rodgutzal/Airsoft-MultipurposeGameModeTool/Hw/esquematico_v1/lista_materiales_v0.9_opcionC.xlsx

Sheet: Opción C (discreta PCB)
Herramienta multipropósito para airsoft: lista de materiales opción C
Todo discreto para PCB propia: ESP32-S3-WROOM-1 N16R8, TP4056 + DW01A/FS8205A, TPS61022, AP7361C, MAX98357A suelto, USB-C. Esquemático v0.9 opción C. Precios en MXN, aproximados. 8 de noviembre de 2026.
Celdas con texto azul: cantidades y precios que se pueden editar. Los subtotales y totales se recalculan solos.
Cant. | Referencias | Pieza | Bloque | Precio unitario (MXN) | Subtotal (MXN) | Estado del precio
1 | U1 | Módulo ESP32-S3-WROOM-1-N16R8 (flash 16 MB quad, PSRAM 8 MB octal), sin tarjeta de desarrollo | Microcontrolador | $120.00 |  | Estimado, sin verificar
1 | U9 | Regulador LDO AP7361C-33E, 3.3 V 1 A, SOT-223 | Alimentación | $8.00 |  | Estimado, sin verificar
1 | SW5 | Botón táctil 6x6 mm (RESET, a EN) | Microcontrolador | $2.00 |  | Estimado, sin verificar
1 | SW6 | Botón táctil 6x6 mm (BOOT, a GPIO0) | Microcontrolador | $2.00 |  | Estimado, sin verificar
1 | J1 | Conector USB-C hembra 16 pines USB 2.0, SMD con postes | USB y depuración | $6.00 |  | Estimado, sin verificar
1 | U7 | Protección ESD USBLC6-2SC6, SOT-23-6 (D+ y D-) | USB y depuración | $5.00 |  | Estimado, sin verificar
1 | J2 | Header macho 1x6 a 2.54 mm (GND, TX0, RX0, EN, IO0, 3V3) | USB y depuración | $3.00 |  | Estimado, sin verificar
1 | DS1 | Módulo TFT 3.5in 480x320 ILI9486 ("3.5' LCD MODULE"), bus paralelo 8080 de 16 bits, touch resistivo XPT2046 por SPI, microSD y conector 2x17 | Pantalla | $300.00 |  | Roy ya lo tiene; precio estimado
1 |  | Header hembra 2x17 a 2.54 mm para conectar DS1 a la PCB | Pantalla | $15.00 |  | Estimado, sin verificar
1 | KP1 | Teclado de membrana 4x4 | Entradas | $40.00 |  | Estimado, sin verificar
1 | U6 | Expansor de E/S I2C MCP23017-E/SP DIP-28 (teclado, switches, botón, PEN, BL, SD del amplificador, USB presente) | Entradas | $50.00 |  | Estimado, sin verificar
1 |  | Zócalo DIP-28 angosto para U6 | Entradas | $8.00 |  | Estimado, sin verificar
1 | SW1 | Interruptor de palanca (selector de equipo) | Entradas | $25.00 |  | Estimado, sin verificar
1 | SW2 | Interruptor de llave (armado de bomba) | Entradas | $80.00 |  | Estimado, sin verificar
1 | SW3 | Push button de panel 16 a 22 mm | Entradas | $40.00 |  | Estimado, sin verificar
2 | BT1, BT2 | Celda 18650 3000 mAh de marca (Samsung 30Q, LG HG2 o similar) | Alimentación | $120.00 |  | Estimado, sin verificar
1 |  | Portapilas 2x18650 para PCB (pines THT), celdas en paralelo | Alimentación | $35.00 |  | Estimado, sin verificar
1 | U10 | Protección de una celda DW01A, SOT-23-6 | Alimentación | $3.00 |  | Estimado, sin verificar
2 | Q1, Q2 | Doble MOSFET N FS8205A, TSSOP-8 (dos en paralelo) | Alimentación | $3.00 |  | Estimado, sin verificar
1 | U2 | Cargador Li-ion TP4056, ESOP-8 con pad expuesto, 1 A | Alimentación | $3.00 |  | Estimado, sin verificar
1 | D6 | LED rojo 0805 o 3 mm (cargando) | Alimentación | $1.00 |  | Estimado, sin verificar
1 | D7 | LED verde 0805 o 3 mm (carga terminada) | Alimentación | $1.00 |  | Estimado, sin verificar
1 | Q3 | MOSFET P AO3401A, SOT-23 (reparto de carga) | Alimentación | $2.00 |  | Estimado, sin verificar
2 | D8, D9 | Diodo Schottky SS34, SMA (D8 de VBUS a VSYS, D9 en paralelo con Q3) | Alimentación | $2.00 |  | Estimado, sin verificar
1 | SW4 | Interruptor de encendido de panel, 3 A o más (palanca o balancín) | Alimentación | $25.00 |  | Estimado, sin verificar
1 | U8 | Elevador síncrono TPS61022RWUR, VQFN-7 2x2 mm (5.1 V, válvula de 8 A) | Alimentación | $25.00 |  | Estimado, sin verificar
1 | L1 | Inductor de potencia blindado 1 uH, saturación de 8 A o más, baja DCR | Alimentación | $20.00 |  | Estimado, sin verificar
1 | DS2, DS3 | Tira LED RGB direccionable WS2812B 5 V, 60 LEDs/m, IP65, rollo de 1 m (2 tramos de 15 LEDs encadenados en un solo dato) | Salidas | $180.00 |  | Estimado, sin verificar
1 | U5 | 74AHCT125 DIP-14 (SN74AHCT125N), subida de nivel 3.3 a 5 V del dato de las tiras; el 74HCT125 también sirve | Salidas | $30.00 |  | Estimado, sin verificar
1 | D5 | LED verde 5 mm difuso, Vf ~2.1 V, LED de estado en GPIO43 | Salidas | $2.00 |  | Estimado, sin verificar
2 |  | Par de conectores JST SM de 3 pines con cable, para desconectar las tiras | Salidas | $10.00 |  | Estimado, sin verificar
1 | U4 | Amplificador I2S clase D MAX98357AETE+, TQFN-16 3x3 mm (circuito integrado suelto) | Audio | $45.00 |  | Estimado, sin verificar
1 | J4 | Conector de 2 pines para la bocina (JST XH o bornera de 3.5 mm) | Audio | $4.00 |  | Estimado, sin verificar
1 | LS1 | Bocina 4 ohm, 3 a 5 W, cono de 40 a 57 mm | Audio | $60.00 |  | Estimado, sin verificar
14 | R1, R2, R3, R4, R7, R17, R18, R19, R20, R22, R23, R24, R36, R37 | Resistencia 10k 0603 (pull-ups, EN, GPIO0, pull-down de GPIO45, RX0, gate de Q3) | Pasivos | $0.50 |  | Estimado, sin verificar
3 | R5, R8, R21 | Resistencia 330 ohm 0603 | Pasivos | $0.50 |  | Estimado, sin verificar
5 | R6, R9, R13, R14, R39 | Resistencia 100k 0603 | Pasivos | $0.50 |  | Estimado, sin verificar
1 | R16 | Resistencia 100k 1% 0603 (realimentación de U8) | Pasivos | $0.50 |  | Estimado, sin verificar
1 | R15 | Resistencia 750k 1% 0603 (realimentación de U8) | Pasivos | $0.50 |  | Estimado, sin verificar
1 | R30 | Resistencia 634k 1% 0603 (SD_MODE del MAX98357A) | Pasivos | $0.50 |  | Estimado, sin verificar
2 | R10, R11 | Resistencia 4.7k 0603 (pull-ups del I2C) | Pasivos | $0.50 |  | Estimado, sin verificar
2 | R25, R26 | Resistencia 5.1k 0603 (CC1 y CC2 del USB-C) | Pasivos | $0.50 |  | Estimado, sin verificar
2 | R27, R28 | Resistencia 22 ohm 0603 (D+ y D-) | Pasivos | $0.50 |  | Estimado, sin verificar
1 | R29 | Resistencia 499 ohm 0603 (TX0) | Pasivos | $0.50 |  | Estimado, sin verificar
1 | R31 | Resistencia 100 ohm 0603 (VCC del DW01A) | Pasivos | $0.50 |  | Estimado, sin verificar
3 | R32, R34, R35 | Resistencia 1k 0603 (CS del DW01A, LEDs de carga) | Pasivos | $0.50 |  | Estimado, sin verificar
1 | R33 | Resistencia 1.2k 1% 0603 (PROG del TP4056, 1 A) | Pasivos | $0.50 |  | Estimado, sin verificar
1 | R38 | Resistencia 47k 0603 (USB presente) | Pasivos | $0.50 |  | Estimado, sin verificar
7 | C1, C2, C4, C7, C9, C12, C14 | Capacitor cerámico 100 nF 0603 | Pasivos | $0.50 |  | Estimado, sin verificar
1 | C10 | Capacitor cerámico 1 uF 0603 (EN) | Pasivos | $0.50 |  | Estimado, sin verificar
6 | C13, C15, C16, C21, C22, C23 | Capacitor cerámico 10 uF 10 V X5R 0805 | Pasivos | $1.00 |  | Estimado, sin verificar
5 | C11, C17, C18, C19, C20 | Capacitor cerámico 22 uF 10 V X5R 0805 o 1206 | Pasivos | $1.50 |  | Estimado, sin verificar
1 | C3 | Capacitor electrolítico 470 uF 10 V | Pasivos | $8.00 |  | Estimado, sin verificar
1 | C8 | Capacitor electrolítico 1000 uF 10 V (entrada de las tiras) | Pasivos | $12.00 |  | Estimado, sin verificar
1 |  | PCB de 2 capas, unos 100 x 100 mm (JLCPCB o PCBWay, lote de 5 con envío, precio por pieza) | PCB | $80.00 |  | Estimado, sin verificar
Total sin gabinete
Margen para repuestos y piezas dañadas |  |  |  |  | 10%
Total con margen

Sheet: Notas
Comparación y supuestos
Total opción C (sin margen)
Total opción A v0.8 (módulos, de lista_materiales_v0.8.xlsx) | $1791.00
Total opción B v0.8 (TP4056 + MT3608, de lista_materiales_v0.8.xlsx) | $1635.00
Diferencia A menos C
Todos los precios de la opción C son estimaciones mías y no se verificaron en tienda. Los de piezas SMD salen de precios típicos de LCSC y AliExpress convertidos a unos 18.5 MXN por dólar; en esas tiendas se compra por lote (10 o más), así que el desembolso real es mayor que el precio por unidad.
El módulo ESP32-S3-WROOM-1-N16R8 se consigue en LCSC, AliExpress y Mercado Libre. Verificar que diga N16R8 (flash 16 MB, PSRAM 8 MB octal a 3.3 V) y no N16R16V, que trabaja la PSRAM y GPIO47/48 a 1.8 V.
TPS61022 (VQFN-7 de 2x2 mm) y MAX98357A (TQFN-16 de 3x3 mm) no se sueldan con cautín. Hace falta esténcil y aire caliente o placa de calor, o pedir el ensamble SMD a JLCPCB o PCBWay, que tienen las dos piezas en catálogo.
La PCB se estimó en 80 MXN por pieza para un lote de 5 de 2 capas con envío. Espressif recomienda 4 capas para el ESP32-S3; con el módulo WROOM funciona en 2 capas cuidando el plano de tierra y la zona de la antena.
No incluye gabinete, cables, tornillería ni el esténcil.
v0.9 opción C (8 de noviembre de 2026): se quitan el ESP32-S3-DevKitC-1, el módulo LUORNG V8 y la tarjeta MAX98357A. Entran U1 WROOM-1, U2 TP4056, U4 MAX98357A suelto, U7 USBLC6, U8 TPS61022, U9 AP7361C, U10 DW01A, Q1/Q2 FS8205A, Q3 AO3401A, D6 a D9, L1, J1 USB-C, J2 UART, J4 bocina, SW4 a SW6, R22 a R39 y C10 a C23.
Lo que no pude verificar con hoja de datos está en Hw/esquematico_v1/opcion_c/README.md, sección Sin verificar.
