rodgutzal/Airsoft-MultipurposeGameModeTool/Hw/esquematico_v1/lista_materiales_v0.8.xlsx

Sheet: Opción A (módulo)
Herramienta multipropósito para airsoft: lista de materiales opción A
Alimentación con módulo LUORNG V8 para 2 celdas 18650. Esquemático v0.8. Precios en MXN, aproximados. 8 de noviembre de 2026.
Celdas con texto azul: cantidades y precios que se pueden editar. Los subtotales y totales se recalculan solos.
Cant. | Referencias | Pieza | Bloque | Precio unitario (MXN) | Subtotal (MXN) | Estado del precio
1 | U1 | ESP32-S3-DevKitC-1 N16R8 | Microcontrolador | $300.00 |  | Estimado, sin verificar
1 | DS1 | Módulo TFT 3.5in 480x320 ILI9486 ("3.5' LCD MODULE"), bus paralelo 8080 de 16 bits, touch resistivo XPT2046 por SPI, microSD y conector 2x17 | Pantalla | $300.00 |  | Roy ya lo tiene; precio estimado
1 | KP1 | Teclado de membrana 4x4 | Entradas | $40.00 |  | Estimado, sin verificar
1 | U6 | Expansor de E/S I2C MCP23017-E/SP DIP-28 (teclado, switches, botón, PEN del touch y BL de la pantalla) | Entradas | $50.00 |  | Estimado, sin verificar
1 |  | Zócalo DIP-28 angosto para U6 | Entradas | $8.00 |  | Estimado, sin verificar
2 | BT1, BT2 | Celda 18650 3000 mAh de marca (Samsung 30Q, LG HG2 o similar) | Alimentación | $120.00 |  | Estimado, sin verificar
1 | M1 | Módulo LUORNG V8 para 2 celdas 18650, carga USB-C y micro USB, salida 5 V y 3 V | Alimentación | $278.10 |  | Precio en captura de Roy, 2 nov 2026
1 | SW1 | Interruptor de palanca (selector de equipo) | Entradas | $25.00 |  | Estimado, sin verificar
1 | SW2 | Interruptor de llave (armado de bomba) | Entradas | $80.00 |  | Estimado, sin verificar
1 | SW3 | Push button de panel 16 a 22 mm | Entradas | $40.00 |  | Estimado, sin verificar
1 | DS2, DS3 | Tira LED RGB direccionable WS2812B 5 V, 60 LEDs/m, IP65, rollo de 1 m (2 tramos de 15 LEDs encadenados en un solo dato) | Salidas | $180.00 |  | Estimado, sin verificar
1 | U5 | 74AHCT125 DIP-14 (SN74AHCT125N), subida de nivel 3.3 a 5 V del dato de las tiras (se usa un buffer); el 74HCT125 también sirve | Salidas | $30.00 |  | Estimado, sin verificar
1 | D5 | LED verde 5 mm difuso, Vf ~2.1 V (verde estándar de 565 a 570 nm), LED de estado en GPIO43 | Salidas | $2.00 |  | Estimado, sin verificar
2 |  | Par de conectores JST SM de 3 pines con cable, para desconectar las tiras | Salidas | $10.00 |  | Estimado, sin verificar
1 | U4 | Módulo amplificador I2S MAX98357A | Audio | $90.00 |  | Estimado, sin verificar
1 | LS1 | Bocina 4 ohm, 3 a 5 W, cono de 40 a 57 mm | Audio | $60.00 |  | Estimado, sin verificar
9 | R1, R2, R3, R4, R7, R17, R18, R19, R20 | Resistencia 10k (R2 a R4 y R17 a R20 son pull-ups de entradas, R7 al RESET de U6) | Pasivos | $1.00 |  | Estimado, sin verificar
3 | R5, R8, R21 | Resistencia 330 ohm (R5 en el dato de DS2, R8 entre DS2 y DS3, R21 limita el LED de estado) | Pasivos | $1.00 |  | Estimado, sin verificar
4 | R6, R9, R13, R14 | Resistencia 100k (R6 pull-down del dato de las tiras, R9 pull-down de arranque de GPIO46) | Pasivos | $1.00 |  | Estimado, sin verificar
2 | R10, R11 | Resistencia 4.7k (pull-ups del bus I2C) | Pasivos | $1.00 |  | Estimado, sin verificar
5 | C1, C2, C4, C7, C9 | Capacitor 100 nF | Pasivos | $2.00 |  | Estimado, sin verificar
1 | C3 | Capacitor electrolítico 470 uF 10 V | Pasivos | $8.00 |  | Estimado, sin verificar
1 | C8 | Capacitor electrolítico 1000 uF 10 V (entrada de las tiras) | Pasivos | $12.00 |  | Estimado, sin verificar
Total sin gabinete
Margen para repuestos y piezas dañadas |  |  |  |  | 10%
Total con margen

Sheet: Opción B (discreta)
Herramienta multipropósito para airsoft: lista de materiales opción B
Alimentación con TP4056 y MT3608 discretos. Esquemático v0.8. Precios en MXN, aproximados. 8 de noviembre de 2026.
Celdas con texto azul: cantidades y precios que se pueden editar. Los subtotales y totales se recalculan solos.
Cant. | Referencias | Pieza | Bloque | Precio unitario (MXN) | Subtotal (MXN) | Estado del precio
1 | U1 | ESP32-S3-DevKitC-1 N16R8 | Microcontrolador | $300.00 |  | Estimado, sin verificar
1 | DS1 | Módulo TFT 3.5in 480x320 ILI9486 ("3.5' LCD MODULE"), bus paralelo 8080 de 16 bits, touch resistivo XPT2046 por SPI, microSD y conector 2x17 | Pantalla | $300.00 |  | Roy ya lo tiene; precio estimado
1 | KP1 | Teclado de membrana 4x4 | Entradas | $40.00 |  | Estimado, sin verificar
1 | U6 | Expansor de E/S I2C MCP23017-E/SP DIP-28 (teclado, switches, botón, PEN del touch y BL de la pantalla) | Entradas | $50.00 |  | Estimado, sin verificar
1 |  | Zócalo DIP-28 angosto para U6 | Entradas | $8.00 |  | Estimado, sin verificar
2 | BT1, BT2 | Celda 18650 3000 mAh de marca (Samsung 30Q, LG HG2 o similar) | Alimentación | $120.00 |  | Estimado, sin verificar
1 |  | Portapilas 2x18650 | Alimentación | $35.00 |  | Estimado, sin verificar
1 | U2 | Módulo TP4056 USB-C con protección (DW01) | Alimentación | $35.00 |  | Estimado, sin verificar
1 | U3 | Circuito integrado MT3608 (SOT-23-6), elevador a 5.2 V | Alimentación | $8.00 |  | Estimado, sin verificar
1 | L1 | Inductor de potencia 22 uH, saturación de 3 A o más, blindado | Alimentación | $12.00 |  | Estimado, sin verificar
2 | C5, C6 | Capacitor cerámico 22 uF 10 V (0805 o 1206) | Pasivos | $5.00 |  | Estimado, sin verificar
1 | SW4 | Interruptor de encendido | Alimentación | $15.00 |  | Estimado, sin verificar
1 | D4 | Diodo Schottky SS34 (diodo del elevador) | Alimentación | $5.00 |  | Estimado, sin verificar
1 | SW1 | Interruptor de palanca (selector de equipo) | Entradas | $25.00 |  | Estimado, sin verificar
1 | SW2 | Interruptor de llave (armado de bomba) | Entradas | $80.00 |  | Estimado, sin verificar
1 | SW3 | Push button de panel 16 a 22 mm | Entradas | $40.00 |  | Estimado, sin verificar
1 | DS2, DS3 | Tira LED RGB direccionable WS2812B 5 V, 60 LEDs/m, IP65, rollo de 1 m (2 tramos de 15 LEDs encadenados en un solo dato) | Salidas | $180.00 |  | Estimado, sin verificar
1 | U5 | 74AHCT125 DIP-14 (SN74AHCT125N), subida de nivel 3.3 a 5 V del dato de las tiras (se usa un buffer); el 74HCT125 también sirve | Salidas | $30.00 |  | Estimado, sin verificar
1 | D5 | LED verde 5 mm difuso, Vf ~2.1 V (verde estándar de 565 a 570 nm), LED de estado en GPIO43 | Salidas | $2.00 |  | Estimado, sin verificar
2 |  | Par de conectores JST SM de 3 pines con cable, para desconectar las tiras | Salidas | $10.00 |  | Estimado, sin verificar
1 | U4 | Módulo amplificador I2S MAX98357A | Audio | $90.00 |  | Estimado, sin verificar
1 | LS1 | Bocina 4 ohm, 3 a 5 W, cono de 40 a 57 mm | Audio | $60.00 |  | Estimado, sin verificar
9 | R1, R2, R3, R4, R7, R17, R18, R19, R20 | Resistencia 10k (R2 a R4 y R17 a R20 son pull-ups de entradas, R7 al RESET de U6) | Pasivos | $1.00 |  | Estimado, sin verificar
3 | R5, R8, R21 | Resistencia 330 ohm (R5 en el dato de DS2, R8 entre DS2 y DS3, R21 limita el LED de estado) | Pasivos | $1.00 |  | Estimado, sin verificar
5 | R6, R9, R13, R14, R15 | Resistencia 100k (R6 pull-down del dato de las tiras, R9 pull-down de arranque de GPIO46) | Pasivos | $1.00 |  | Estimado, sin verificar
2 | R10, R11 | Resistencia 4.7k (pull-ups del bus I2C) | Pasivos | $1.00 |  | Estimado, sin verificar
1 | R16 | Resistencia 13k | Pasivos | $1.00 |  | Estimado, sin verificar
5 | C1, C2, C4, C7, C9 | Capacitor 100 nF | Pasivos | $2.00 |  | Estimado, sin verificar
1 | C3 | Capacitor electrolítico 470 uF 10 V | Pasivos | $8.00 |  | Estimado, sin verificar
1 | C8 | Capacitor electrolítico 1000 uF 10 V (entrada de las tiras) | Pasivos | $12.00 |  | Estimado, sin verificar
Total sin gabinete
Margen para repuestos y piezas dañadas |  |  |  |  | 10%
Total con margen

Sheet: Notas
Comparación y supuestos
Total opción A (sin margen)
Total opción B (sin margen)
Diferencia A menos B
La opción A usa el módulo LUORNG V8, cuyo precio de $278.10 se tomó de las capturas de Roy del 2 de noviembre de 2026. No pude abrir la publicación de Amazon MX.
La opción B es el diseño con TP4056 y MT3608 discretos. Es SMD y requiere PCB propia o placa adaptadora SOT-23-6.
Los demás precios son estimaciones mías y no se verificaron en tienda. Mercado Libre y Amazon MX no permiten lectura automática.
Referencias vistas en tienda el 2 de noviembre de 2026: ESP32 DevKit V1 a 130 MXN más IVA en Teknomovo (https://teknomovo.com.mx/producto/esp32-devkit-v1-wifi-30-pines/), placa tipo ESP32 de Steren a 199 MXN (https://www.steren.com.mx/placa-de-programacion-tipo-esp32.html) y Raspberry Pi Pico 2 W a 208 MXN en 330ohms (https://www.330ohms.com/shop/rp-01633-raspberry-pi-pico-2-w-1563).
La pantalla es el módulo de 3.5in con conector 2x17 que ya tiene Roy. Solo funciona con bus de 16 bits; el touch XPT2046 va por SPI aparte del bus.
El amplificador MAX98357A y la bocina de 4 ohm se eligieron para alcanzar unos 70 dB a 15 m (estimación sin medir).
Pendiente: verificar precios del ESP32-S3-DevKitC-1 N16R8, la pantalla, el MAX98357A y la bocina en Amazon MX, Mercado Libre o AliExpress.
v0.5 (3 de noviembre de 2026): R17 a R20 de 10k como pull-ups externos de las columnas del teclado. Todas las entradas digitales tienen pull-up por hardware y el firmware no usa los internos.
v0.6 (4 de noviembre de 2026): los LEDs rojo y azul de 10 mm (D1, D2, Q1, Q2, R7, R10) se cambian por dos tiras WS2812B (DS2, DS3) con subida de nivel 74AHCT125 (U5), R5/R8 de 330 ohm en serie, C7 de 100 nF y C8 de 1000 uF.
Un rollo de 1 m de 60 LEDs/m alcanza para las dos tiras de 15 LEDs y sobra 40 cm. Si Roy elige otra longitud, el precio del rollo no cambia hasta 1 m.
v0.7 (7 de noviembre de 2026): LED de estado verde de 5 mm (D5) en GPIO43 con R21 de 330 ohm a GND, activo en alto, unos 3.6 mA. GPIO43 es U0TXD: parpadea con los mensajes de arranque de la ROM y el firmware debe sacar la consola de UART0.
v0.8 (8 de noviembre de 2026): pinout de la pantalla corregido al módulo 2x17 de 16 bits (foto de Roy). Se agregan U6 (MCP23017) con su zócalo, R7 de 10k, R10/R11 de 4.7k y C9 de 100 nF. Teclado, switches y botón pasan a U6; las dos tiras quedan encadenadas en GPIO3. La pantalla se alimenta de 3.3 V.
