rodgutzal/Airsoft-MultipurposeGameModeTool/Hw/esquematico_v1/airsoft_tool.pdf

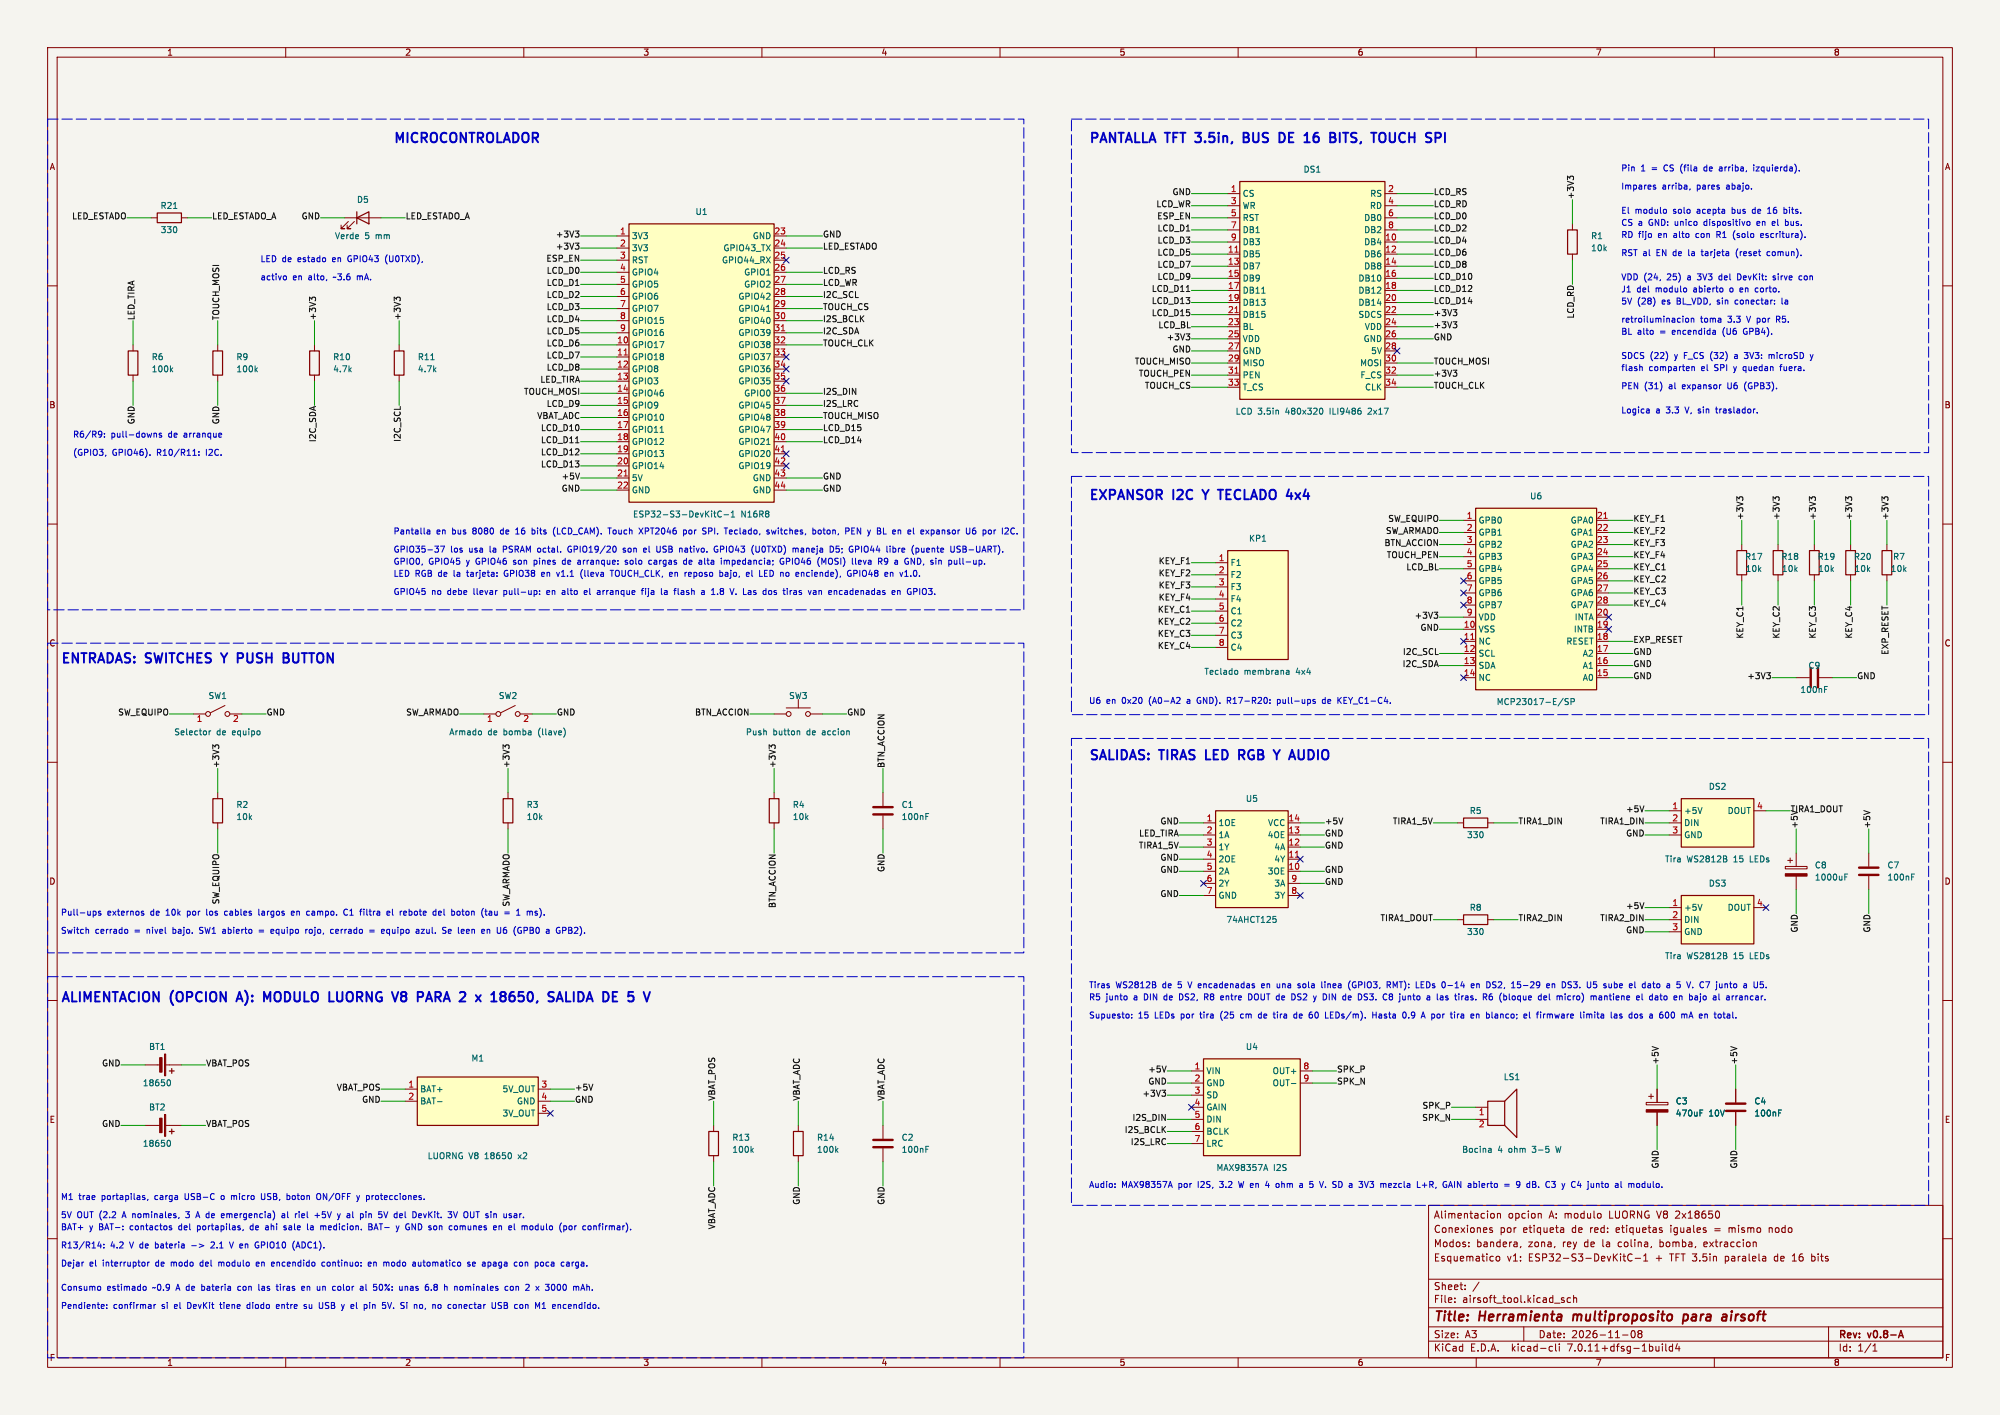
[picture p5: page 1]

PANTALLA TFT 3.5in, BUS DE 16 BITS, TOUCH SPI

Impares arriba, pares abajo.

J1 del modulo abierto o en corto.

100nF SW3 Push button de accion R9

ENTRADAS: SWITCHES Y PUSH BUTTON
