rodgutzal/Airsoft-MultipurposeGameModeTool/Hw/esquematico_v1/opcion_c/airsoft_tool_opcion_C.pdf

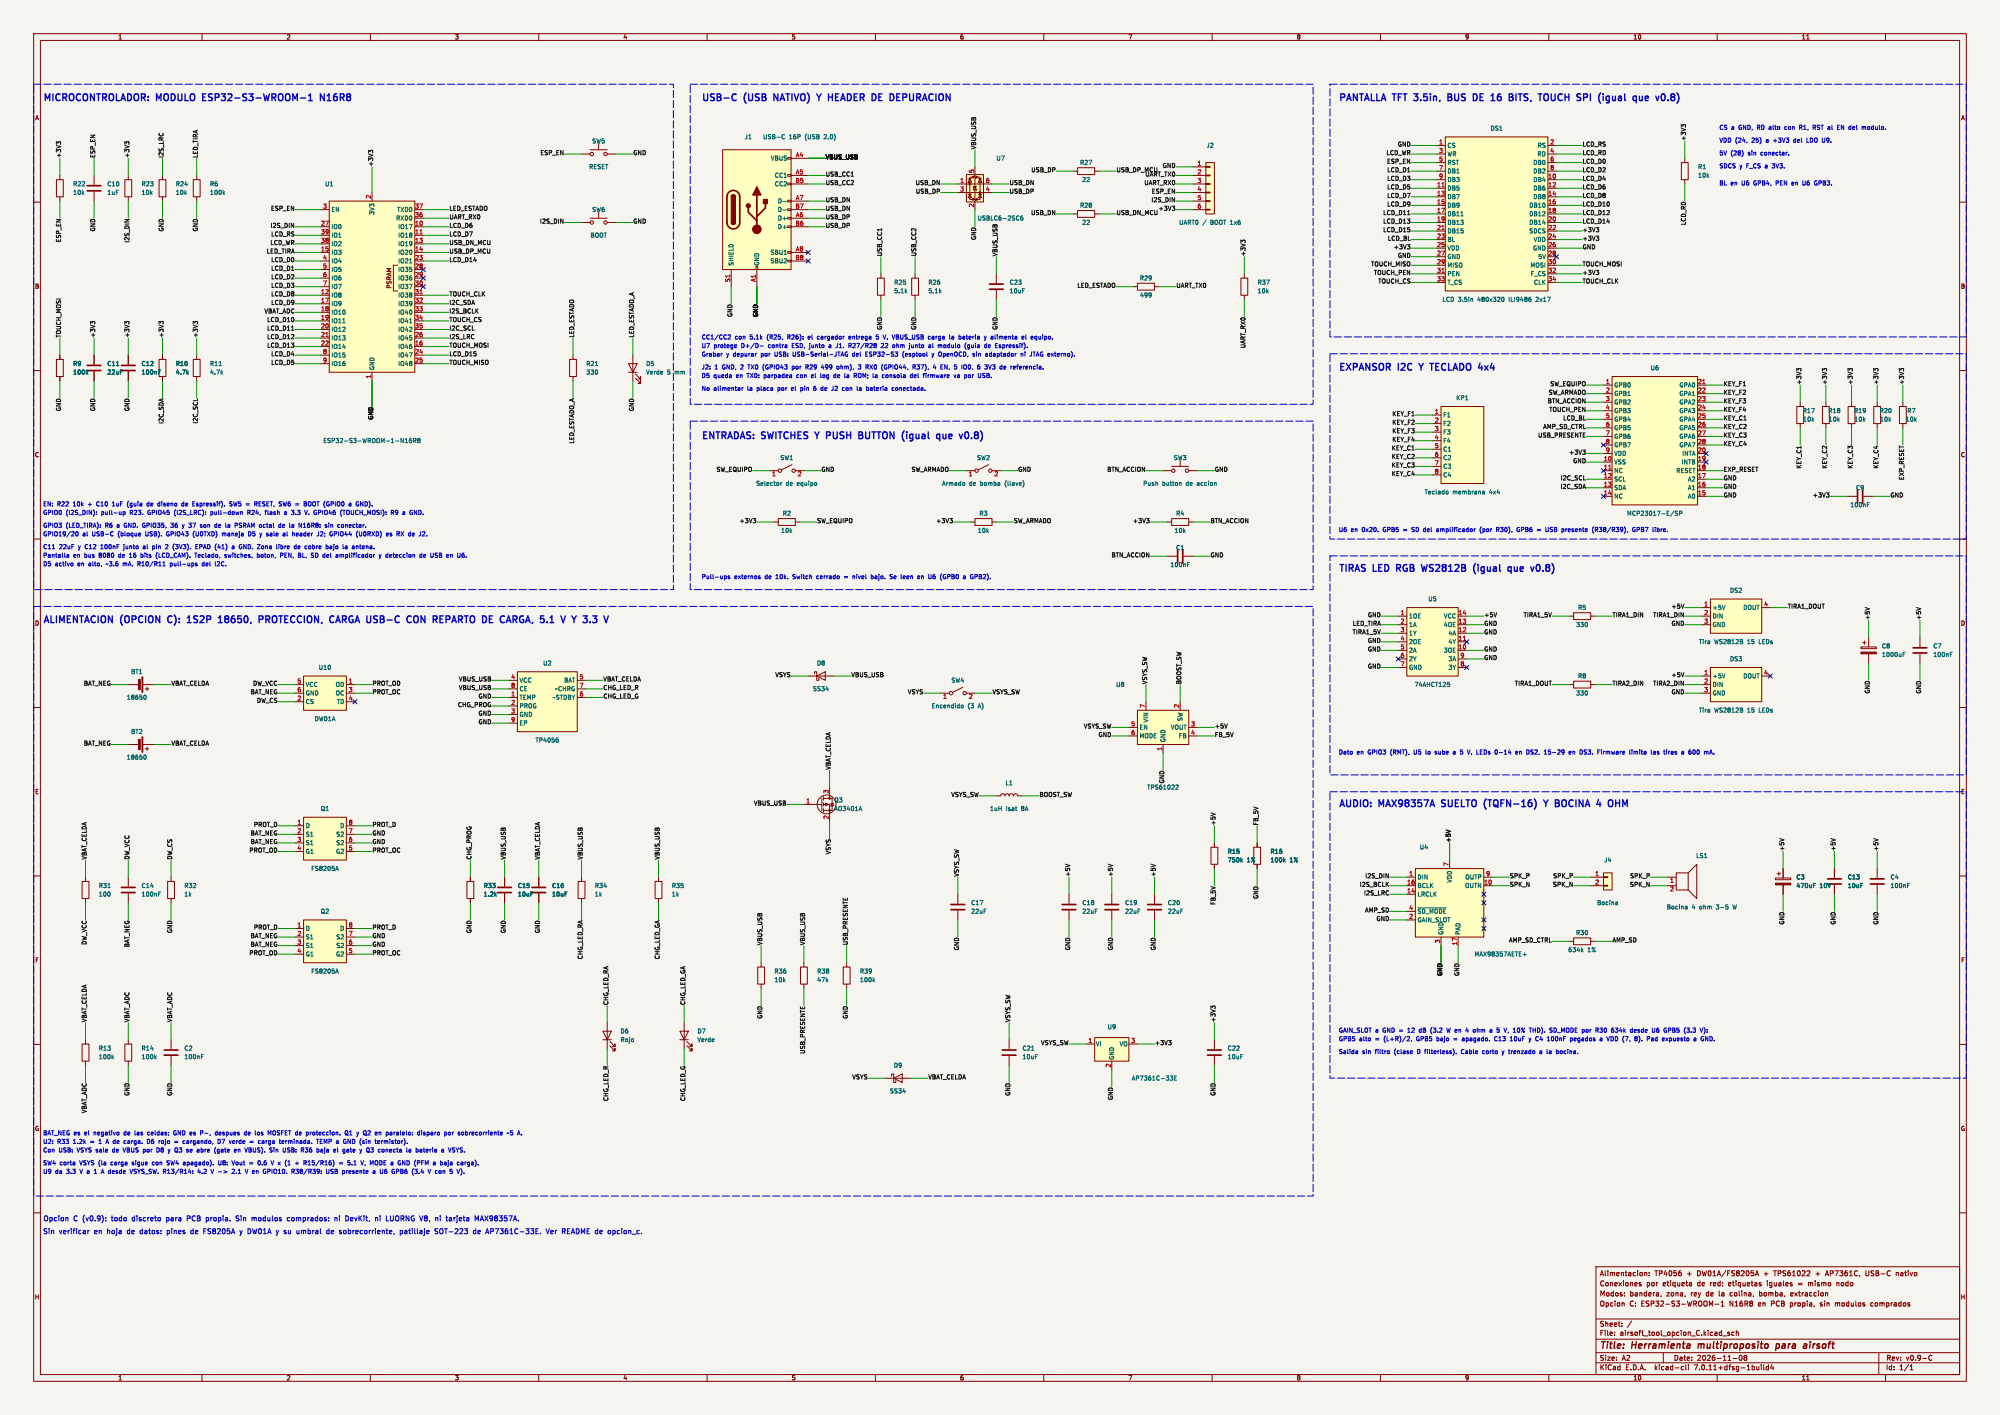
[picture p6: page 1]

SDCS y F_CS a 3V3. BL en U6 GPB4, PEN en U6 GPB3. TIRAS LED RGB WS2812B (igual que v0.8) R9

J2: 1 GND, 2 TX0 (GPIO43 por R29 499 ohm), 3 RX0 (GPIO44, R37), 4 EN, 5 IO0, 6 3V3 de referencia.

SPK_P GND GND GND GND
