rodgutzal/Airsoft-MultipurposeGameModeTool/Hw/esquematico_v1/opcion_b/airsoft_tool_opcion_B.pdf

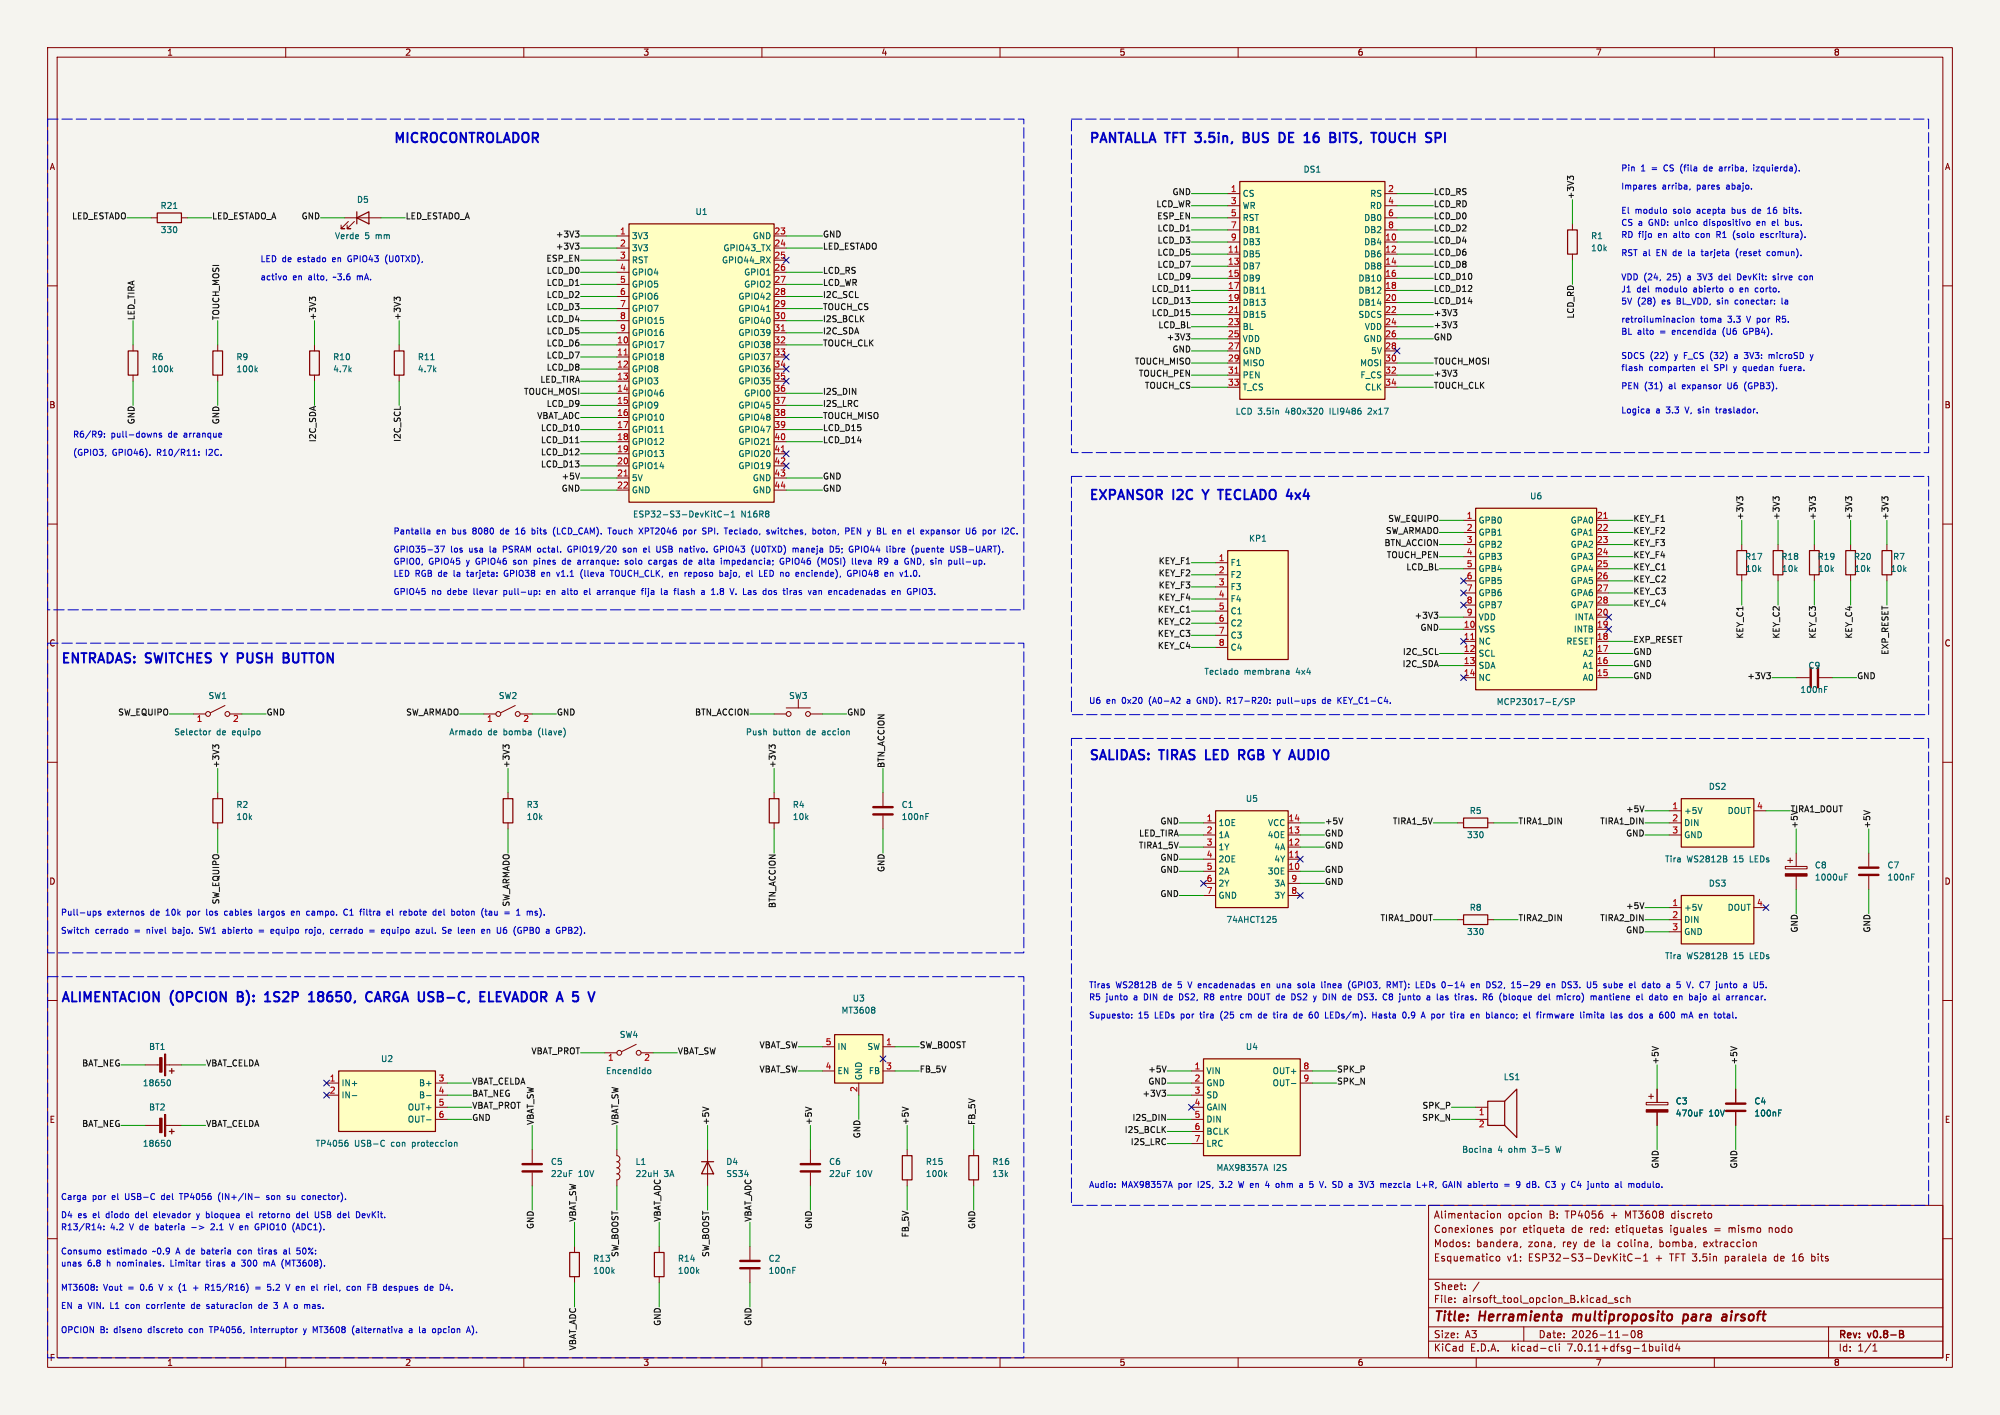
[picture p7: page 1]

Pin 1 = CS (fila de arriba, izquierda).

El modulo solo acepta bus de 16 bits. EXPANSOR I2C Y TECLADO 4x4

RD fijo en alto con R1 (solo escritura).

LED de estado en GPIO43 (U0TXD),

Logica a 3.3 V, sin traslador. VDD (24, 25) a 3V3 del DevKit: sirve con

ENTRADAS: SWITCHES Y PUSH BUTTON

SALIDAS: TIRAS LED RGB Y AUDIO

Switch cerrado = nivel bajo. SW1 abierto = equipo rojo, cerrado = equipo azul. Se leen en U6 (GPB0 a GPB2).

VIN 1 GND 2 SD 3 GAIN 4 DIN 5 BCLK 6
