rodgutzal/Airsoft-MultipurposeGameModeTool/Hw/pcb/airsoft_tool_opcion_C.kicad_pcb

## KiCad design Hw/pcb/airsoft_tool_opcion_C.kicad_pcb (2026-11-12)

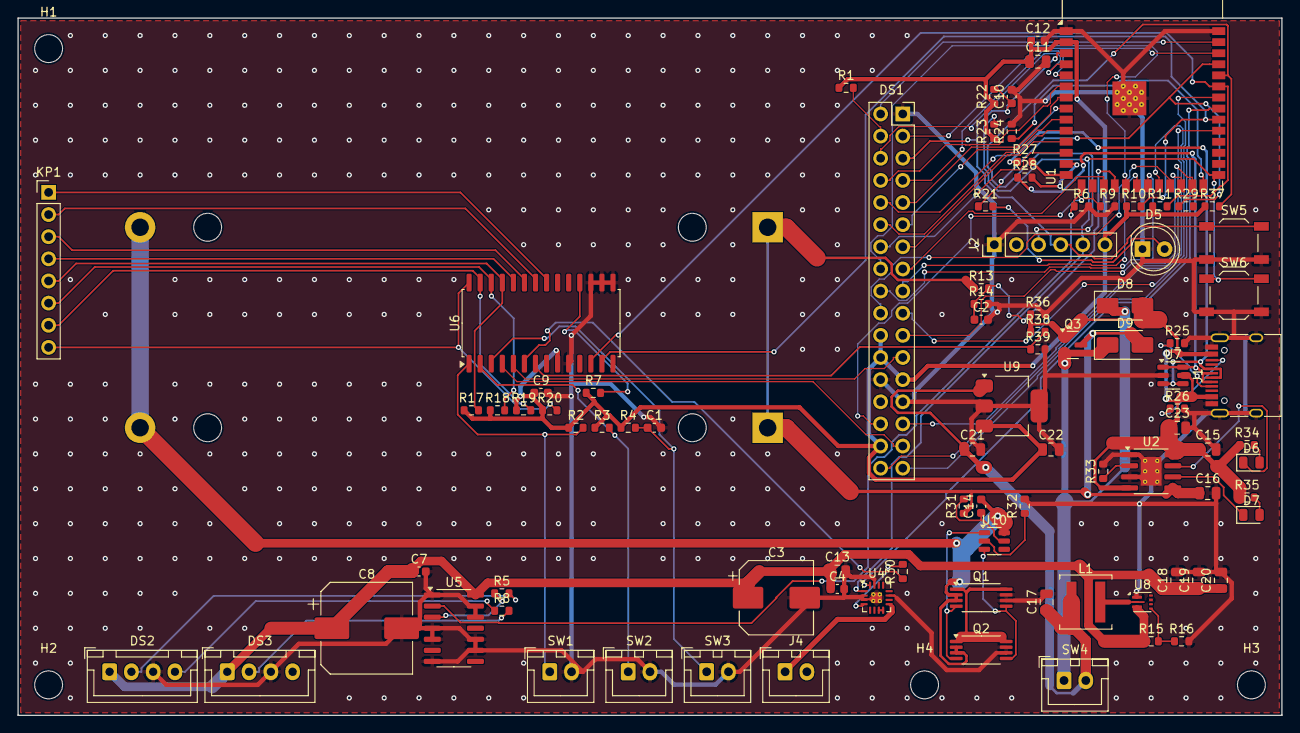
[picture p8: board airsoft_tool_opcion_C.kicad_pcb from above]

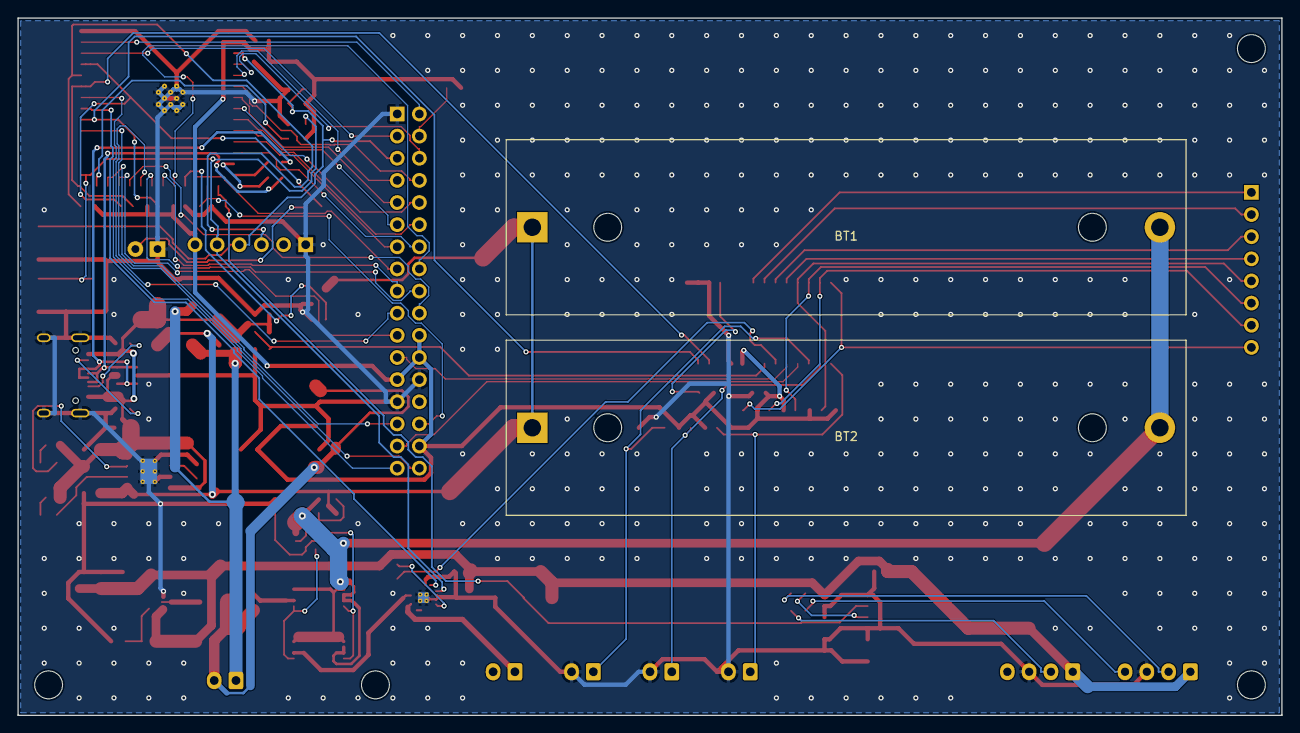
[picture p9: board airsoft_tool_opcion_C.kicad_pcb from below]

Board: 2 copper layers, 145.0 x 80.0 mm, 96 parts (2 on the bottom side), 84 nets.

Parts:
BT1, BT2: 18650; BatteryHolder_MPD_BH-18650-PC2
C1, C2, C4, C7, C9, C12, C14: 100nF; C_0603_1608Metric
C3: 470uF 10V; CP_Elec_8x10
C8: 1000uF; CP_Elec_10x10
C10: 1uF; C_0603_1608Metric
C11, C17, C18, C19, C20: 22uF; C_0805_2012Metric
C13, C15, C16, C21, C22, C23: 10uF; C_0805_2012Metric
D5: Verde 5 mm; LED_D5.0mm
D6: Rojo; LED_0805_2012Metric
D7: Verde; LED_0805_2012Metric
D8, D9: SS34; D_SMA
DS1: LCD 3.5in 480x320 ILI9486 2x17; PinSocket_2x17_P2.54mm_Vertical
DS2, DS3: Tira WS2812B 15 LEDs; JST_XH_B4B-XH-A_1x04_P2.50mm_Vertical
H1, H2, H3, H4: M3; MountingHole_3.2mm_M3
J1: USB-C 16P (USB 2.0); USB_C_Receptacle_HRO_TYPE-C-31-M-12
J2: UART0 / BOOT 1x6; PinHeader_1x06_P2.54mm_Vertical
J4: Bocina; JST_XH_B2B-XH-A_1x02_P2.50mm_Vertical
KP1: Teclado membrana 4x4; PinHeader_1x08_P2.54mm_Vertical
L1: 1uH Isat 8A; L_Coilcraft_XAL5030-XXX
Q1, Q2: FS8205A; TSSOP-8_4.4x3mm_P0.65mm
Q3: AO3401A; SOT-23
R1, R2, R3, R4, R7, R17, R18, R19, R20, R22, R23, R24, R36, R37: 10k; R_0603_1608Metric
R5, R8, R21: 330; R_0603_1608Metric
R6, R9, R13, R14, R39: 100k; R_0603_1608Metric
R10, R11: 4.7k; R_0603_1608Metric
R15: 750k 1%; R_0603_1608Metric
R16: 100k 1%; R_0603_1608Metric
R25, R26: 5.1k; R_0603_1608Metric
R27, R28: 22; R_0603_1608Metric
R29: 499; R_0603_1608Metric
R30: 634k 1%; R_0603_1608Metric
R31: 100; R_0603_1608Metric
R32, R34, R35: 1k; R_0603_1608Metric
R33: 1.2k; R_0603_1608Metric
R38: 47k; R_0603_1608Metric
SW1: Selector de equipo; JST_XH_B2B-XH-A_1x02_P2.50mm_Vertical
SW2: Armado de bomba (llave); JST_XH_B2B-XH-A_1x02_P2.50mm_Vertical
SW3: Push button de accion; JST_XH_B2B-XH-A_1x02_P2.50mm_Vertical
SW4: Encendido (3 A); JST_XH_B2B-XH-A_1x02_P2.50mm_Vertical
SW5: RESET; SW_SPST_TL3342
SW6: BOOT; SW_SPST_TL3342
U1: ESP32-S3-WROOM-1-N16R8; ESP32-S3-WROOM-1
U2: TP4056; SOIC-8-1EP_3.9x4.9mm_P1.27mm_EP2.41x3.3mm_ThermalVias
U4: MAX98357AETE+; TQFN-16-1EP_3x3mm_P0.5mm_EP1.23x1.23mm_ThermalVias
U5: 74AHCT125; SOIC-14_3.9x8.7mm_P1.27mm
U6: MCP23017-E/SP; SOIC-28W_7.5x17.9mm_P1.27mm
U7: USBLC6-2SC6; SOT-23-6
U8: TPS61022; Texas_RWU0007A_VQFN-7_2x2mm_P0.5mm
U9: AP7361C-33E; SOT-223-3_TabPin2
U10: DW01A; SOT-23-6

Connections:
/+3V3: C9.1, C11.1, C12.1, C22.1, DS1.22, DS1.24, DS1.25, DS1.32, J2.6, R1.1, R2.1, R3.1, R4.1, R7.1, R10.1, R11.1, R17.1, R18.1, R19.1, R20.1, R22.1, R23.1, R37.1, U1.2, U6.9, U9.3
/+5V: C3.1, C4.1, C7.1, C8.1, C13.1, C18.1, C19.1, C20.1, DS2.1, DS3.1, R15.1, U4.7, U4.8, U5.14, U8.3
/AMP_SD: R30.2, U4.4
/AMP_SD_CTRL: R30.1, U6.6
/BAT_NEG: BT1.2, BT2.2, C14.2, Q1.2, Q1.3, Q2.2, Q2.3, U10.6
/BOOST_SW: L1.2, U8.2
/BTN_ACCION: C1.1, R4.2, SW3.1, U6.3
/CHG_LED_G: D7.1, U2.6
/CHG_LED_GA: D7.2, R35.2
/CHG_LED_R: D6.1, U2.7
/CHG_LED_RA: D6.2, R34.2
/CHG_PROG: R33.1, U2.2
/DW_CS: R32.1, U10.2
/DW_VCC: C14.1, R31.2, U10.5
/ESP_EN: C10.1, DS1.5, J2.4, R22.2, SW5.1, U1.3
/EXP_RESET: R7.2, U6.18
/FB_5V: R15.2, R16.1, U8.4
/GND: C1.2, C2.2, C3.2, C4.2, C7.2, C8.2, C9.2, C10.2, C11.2, C12.2, C13.2, C15.2, C16.2, C17.2, C18.2, C19.2, C20.2, C21.2, C22.2, C23.2, D5.1, DS1.1, DS1.26, DS1.27, DS2.3, DS3.3, J1.A1, J1.A12, J1.B1, J1.B12, J1.S1, J2.1, Q1.6, Q1.7, Q2.6, Q2.7, R6.2, R9.2, R14.2, R16.2, R24.2, R25.2, R26.2, R32.2, R33.2, R36.2, R39.2, SW1.2, SW2.2, SW3.2, SW5.2, SW6.2, U1.1, U1.40, U1.41, U2.1, U2.3, U2.9, U4.2, U4.3, U4.11, U4.15, U4.17, U5.1, U5.4, U5.5, U5.7, U5.9, U5.10, U5.12, U5.13, U6.10, U6.15, U6.16, U6.17, U7.2, U8.1, U8.6, U9.2
/I2C_SCL: R11.2, U1.35, U6.12
/I2C_SDA: R10.2, U1.32, U6.13
/I2S_BCLK: U1.33, U4.16
/I2S_DIN: J2.5, R23.2, SW6.1, U1.27, U4.1
/I2S_LRC: R24.1, U1.26, U4.14
/KEY_C1: KP1.5, R17.2, U6.25
/KEY_C2: KP1.6, R18.2, U6.26
/KEY_C3: KP1.7, R19.2, U6.27
/KEY_C4: KP1.8, R20.2, U6.28
/KEY_F1: KP1.1, U6.21
/KEY_F2: KP1.2, U6.22
/KEY_F3: KP1.3, U6.23
/KEY_F4: KP1.4, U6.24
/LCD_BL: DS1.23, U6.5
/LCD_D0: DS1.6, U1.4
/LCD_D1: DS1.7, U1.5
/LCD_D2: DS1.8, U1.6
/LCD_D3: DS1.9, U1.7
/LCD_D4: DS1.10, U1.8
/LCD_D5: DS1.11, U1.9
/LCD_D6: DS1.12, U1.10
/LCD_D7: DS1.13, U1.11
/LCD_D8: DS1.14, U1.12
/LCD_D9: DS1.15, U1.17
/LCD_D10: DS1.16, U1.19
/LCD_D11: DS1.17, U1.20
/LCD_D12: DS1.18, U1.21
/LCD_D13: DS1.19, U1.22
/LCD_D14: DS1.20, U1.23
/LCD_D15: DS1.21, U1.24
/LCD_RD: DS1.4, R1.2
/LCD_RS: DS1.2, U1.39
/LCD_WR: DS1.3, U1.38
/LED_ESTADO: R21.1, R29.1, U1.37
/LED_ESTADO_A: D5.2, R21.2
/LED_TIRA: R6.1, U1.15, U5.2
/PROT_D: Q1.1, Q1.8, Q2.1, Q2.8
/PROT_OC: Q1.5, Q2.5, U10.3
/PROT_OD: Q1.4, Q2.4, U10.1
/SPK_N: J4.2, U4.10
/SPK_P: J4.1, U4.9
/SW_ARMADO: R3.2, SW2.1, U6.2
/SW_EQUIPO: R2.2, SW1.1, U6.1
/TIRA1_5V: R5.1, U5.3
/TIRA1_DIN: DS2.2, R5.2
/TIRA1_DOUT: DS2.4, R8.1
/TIRA2_DIN: DS3.2, R8.2
/TOUCH_CLK: DS1.34, U1.31
/TOUCH_CS: DS1.33, U1.34
/TOUCH_MISO: DS1.29, U1.25
/TOUCH_MOSI: DS1.30, R9.1, U1.16
/TOUCH_PEN: DS1.31, U6.4
/UART_RX0: J2.3, R37.2, U1.36
/UART_TX0: J2.2, R29.2
/USB_CC1: J1.A5, R25.1
/USB_CC2: J1.B5, R26.1
/USB_DN: J1.A7, J1.B7, R28.1, U7.1, U7.6
/USB_DN_MCU: R28.2, U1.13
/USB_DP: J1.A6, J1.B6, R27.1, U7.3, U7.4
/USB_DP_MCU: R27.2, U1.14
/USB_PRESENTE: R38.2, R39.1, U6.7
/VBAT_ADC: C2.1, R13.2, R14.1, U1.18
/VBAT_CELDA: BT1.1, BT2.1, C16.1, D9.2, Q3.3, R13.1, R31.1, U2.5
/VBUS_USB: C15.1, C23.1, D8.2, J1.A4, J1.A9, J1.B4, J1.B9, Q3.1, R34.1, R35.1, R36.1, R38.1, U2.4, U2.8, U7.5
/VSYS: D8.1, D9.1, Q3.2, SW4.1
/VSYS_SW: C17.1, C21.1, L1.1, SW4.2, U8.5, U8.7, U9.1
