rodgutzal/Airsoft-MultipurposeGameModeTool/Hw/esquematico_v1/opcion_b/airsoft_tool_opcion_B.kicad_sch

## KiCad design Hw/esquematico_v1/opcion_b/airsoft_tool_opcion_B.kicad_sch (2026-11-08)

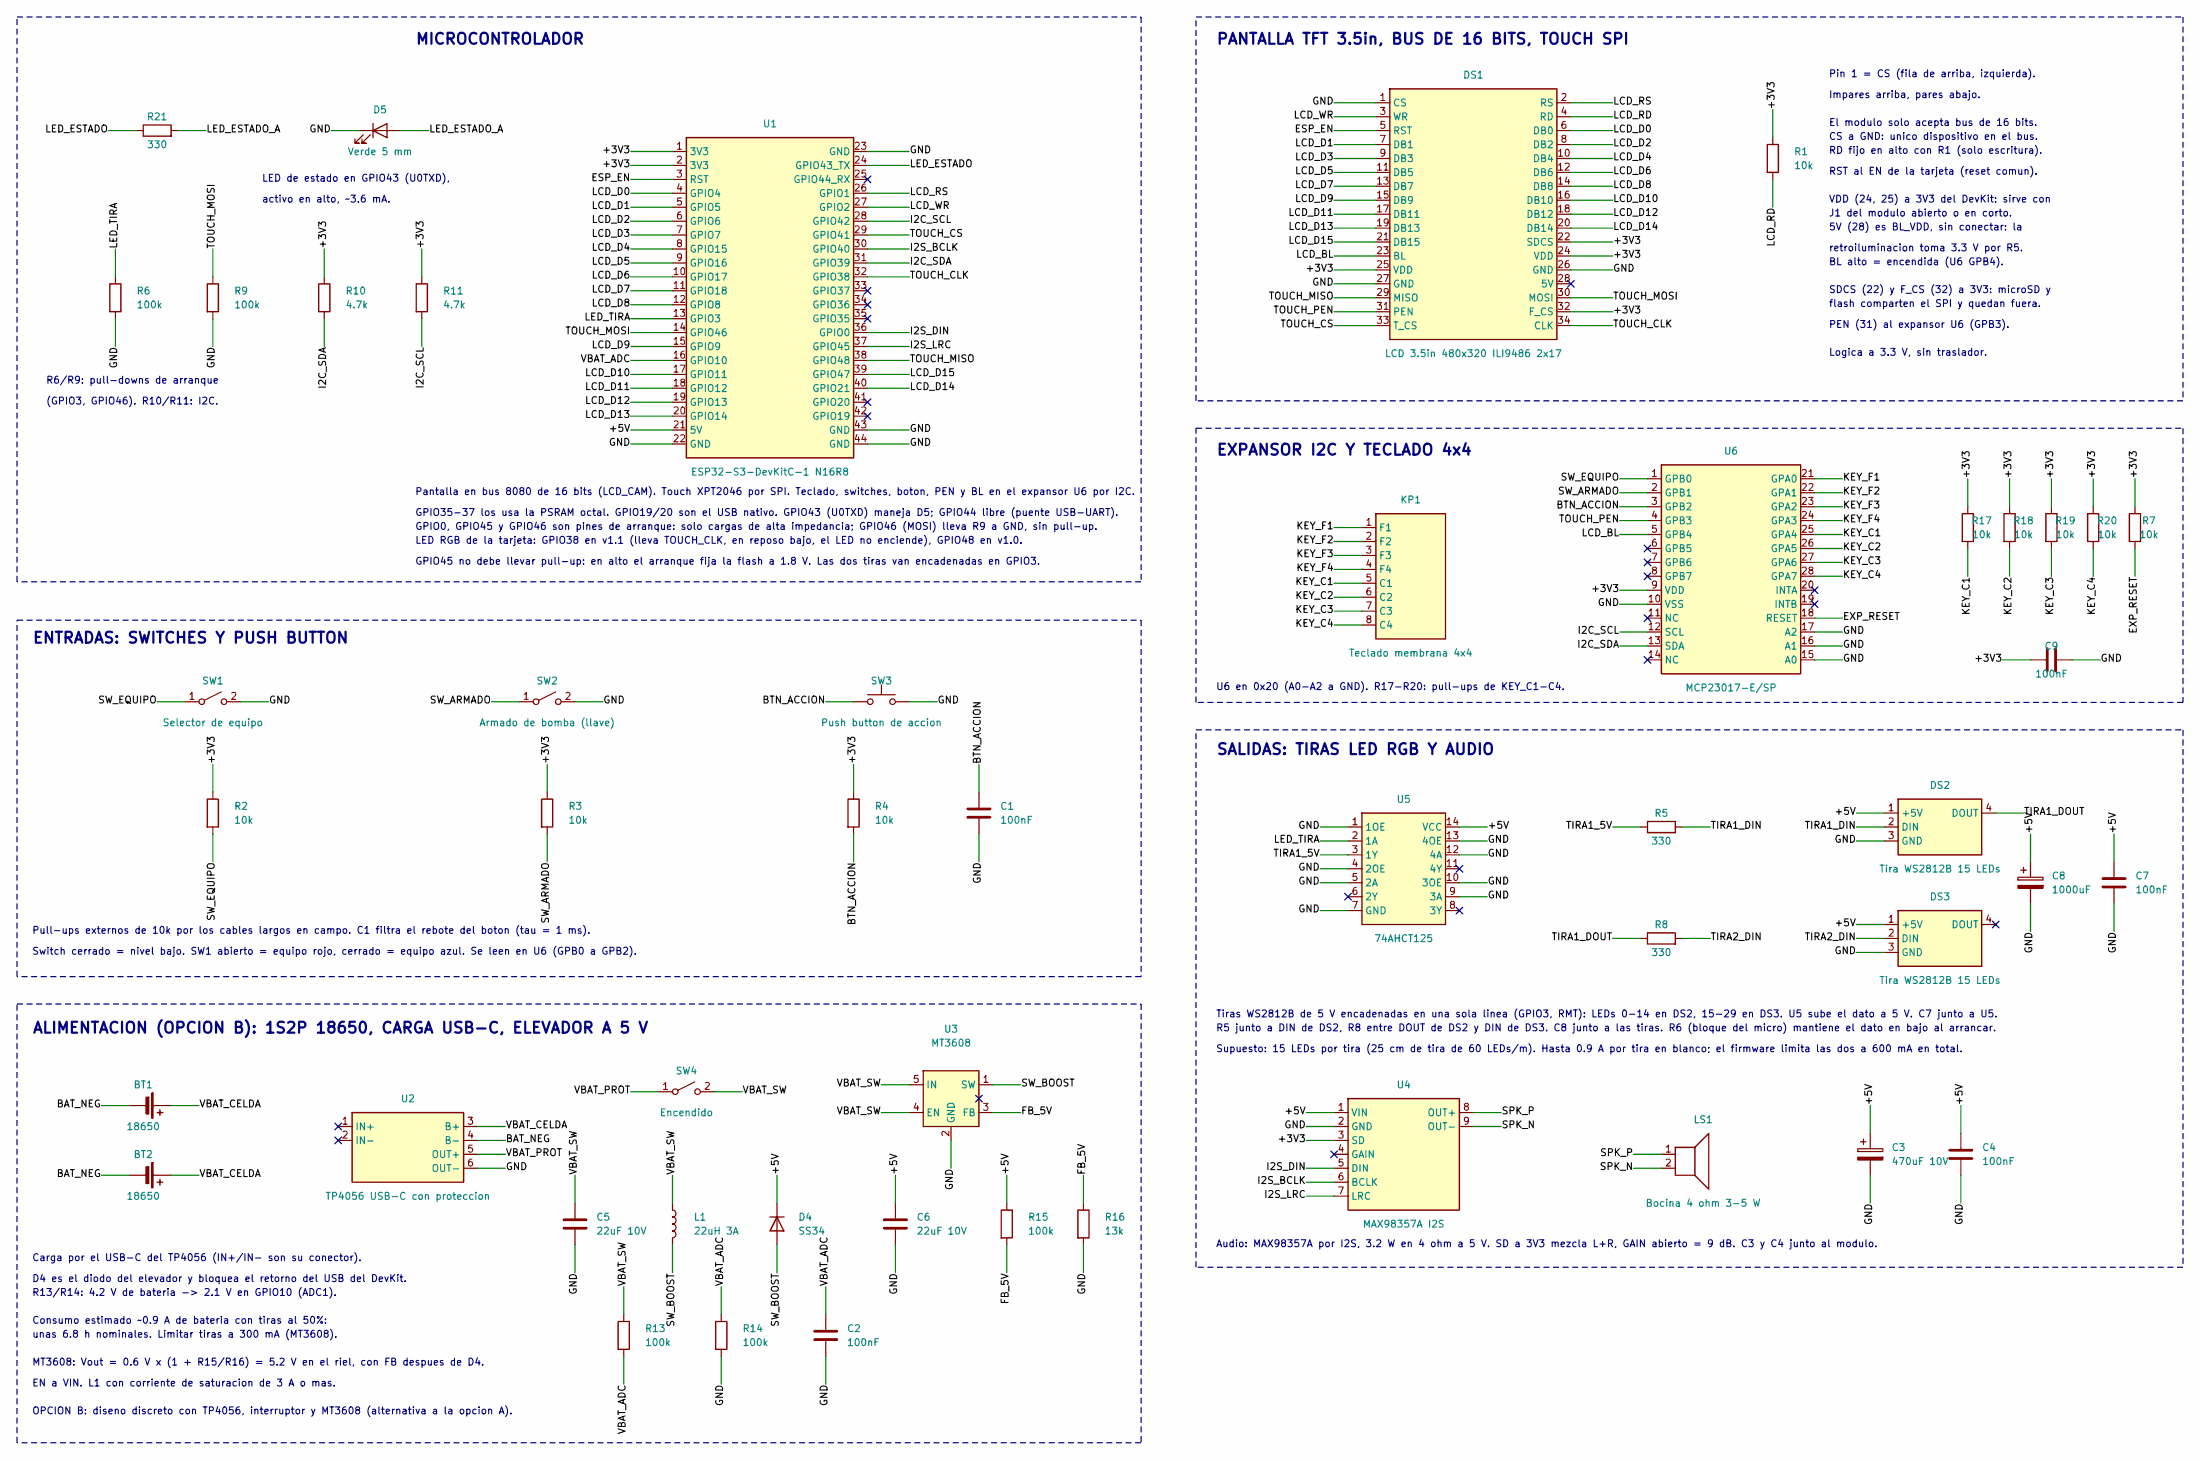
[picture p10: schematic airsoft_tool_opcion_B.kicad_sch]

Parts:
BT1, BT2: 18650
C1, C2, C4, C7, C9: 100nF
C3: 470uF 10V
C5, C6: 22uF 10V
C8: 1000uF
D4: SS34
D5: Verde 5 mm
DS1: LCD 3.5in 480x320 ILI9486 2x17
DS2, DS3: Tira WS2812B 15 LEDs
KP1: Teclado membrana 4x4
L1: 22uH 3A
LS1: Bocina 4 ohm 3-5 W
R1, R2, R3, R4, R7, R17, R18, R19, R20: 10k
R5, R8, R21: 330
R6, R9, R13, R14, R15: 100k
R10, R11: 4.7k
R16: 13k
SW1: Selector de equipo
SW2: Armado de bomba (llave)
SW3: Push button de accion
SW4: Encendido
U1: ESP32-S3-DevKitC-1 N16R8
U2: TP4056 USB-C con proteccion
U3: MT3608
U4: MAX98357A I2S
U5: 74AHCT125
U6: MCP23017-E/SP

Connections:
+3V3: C9.1, DS1.22 (SDCS), DS1.24 (VDD), DS1.25 (VDD), DS1.32 (F_CS), R1.1, R2.1, R3.1, R4.1, R7.1, R10.1, R11.1, R17.1, R18.1, R19.1, R20.1, U1.1 (3V3), U1.2 (3V3), U4.3 (SD), U6.9 (VDD)
+5V: C3.1, C4.1, C6.1, C7.1, C8.1, D4.1 (K), DS2.1 (+5V), DS3.1 (+5V), R15.1, U1.21 (5V), U4.1 (VIN), U5.14 (VCC)
BAT_NEG: BT1.2 (-), BT2.2 (-), U2.4 (B-)
BTN_ACCION: C1.1, R4.2, SW3.1, U6.3 (GPB2)
ESP_EN: DS1.5 (RST), U1.3 (RST)
EXP_RESET: R7.2, U6.18 (RESET)
FB_5V: R15.2, R16.1, U3.3 (FB)
GND: C1.2, C2.2, C3.2, C4.2, C5.2, C6.2, C7.2, C8.2, C9.2, D5.1 (K), DS1.1 (CS), DS1.26 (GND), DS1.27 (GND), DS2.3 (GND), DS3.3 (GND), R6.2, R9.2, R14.2, R16.2, SW1.2 (B), SW2.2 (B), SW3.2, U1.22 (GND), U1.23 (GND), U1.43 (GND), U1.44 (GND), U2.6 (OUT-), U3.2 (GND), U4.2 (GND), U5.1 (1OE), U5.4 (2OE), U5.5 (2A), U5.7 (GND), U5.9 (3A), U5.10 (3OE), U5.12 (4A), U5.13 (4OE), U6.10 (VSS), U6.15 (A0), U6.16 (A1), U6.17 (A2)
I2C_SCL: R11.2, U1.28 (GPIO42), U6.12 (SCL)
I2C_SDA: R10.2, U1.31 (GPIO39), U6.13 (SDA)
I2S_BCLK: U1.30 (GPIO40), U4.6 (BCLK)
I2S_DIN: U1.36 (GPIO0), U4.5 (DIN)
I2S_LRC: U1.37 (GPIO45), U4.7 (LRC)
KEY_C1: KP1.5 (C1), R17.2, U6.25 (GPA4)
KEY_C2: KP1.6 (C2), R18.2, U6.26 (GPA5)
KEY_C3: KP1.7 (C3), R19.2, U6.27 (GPA6)
KEY_C4: KP1.8 (C4), R20.2, U6.28 (GPA7)
KEY_F1: KP1.1 (F1), U6.21 (GPA0)
KEY_F2: KP1.2 (F2), U6.22 (GPA1)
KEY_F3: KP1.3 (F3), U6.23 (GPA2)
KEY_F4: KP1.4 (F4), U6.24 (GPA3)
LCD_BL: DS1.23 (BL), U6.5 (GPB4)
LCD_D0: DS1.6 (DB0), U1.4 (GPIO4)
LCD_D1: DS1.7 (DB1), U1.5 (GPIO5)
LCD_D2: DS1.8 (DB2), U1.6 (GPIO6)
LCD_D3: DS1.9 (DB3), U1.7 (GPIO7)
LCD_D4: DS1.10 (DB4), U1.8 (GPIO15)
LCD_D5: DS1.11 (DB5), U1.9 (GPIO16)
LCD_D6: DS1.12 (DB6), U1.10 (GPIO17)
LCD_D7: DS1.13 (DB7), U1.11 (GPIO18)
LCD_D8: DS1.14 (DB8), U1.12 (GPIO8)
LCD_D9: DS1.15 (DB9), U1.15 (GPIO9)
LCD_D10: DS1.16 (DB10), U1.17 (GPIO11)
LCD_D11: DS1.17 (DB11), U1.18 (GPIO12)
LCD_D12: DS1.18 (DB12), U1.19 (GPIO13)
LCD_D13: DS1.19 (DB13), U1.20 (GPIO14)
LCD_D14: DS1.20 (DB14), U1.40 (GPIO21)
LCD_D15: DS1.21 (DB15), U1.39 (GPIO47)
LCD_RD: DS1.4 (RD), R1.2
LCD_RS: DS1.2 (RS), U1.26 (GPIO1)
LCD_WR: DS1.3 (WR), U1.27 (GPIO2)
LED_ESTADO: R21.1, U1.24 (GPIO43_TX)
LED_ESTADO_A: D5.2 (A), R21.2
LED_TIRA: R6.1, U1.13 (GPIO3), U5.2 (1A)
SPK_N: LS1.2, U4.9 (OUT-)
SPK_P: LS1.1, U4.8 (OUT+)
SW_ARMADO: R3.2, SW2.1 (A), U6.2 (GPB1)
SW_BOOST: D4.2 (A), L1.2, U3.1 (SW)
SW_EQUIPO: R2.2, SW1.1 (A), U6.1 (GPB0)
TIRA1_5V: R5.1, U5.3 (1Y)
TIRA1_DIN: DS2.2 (DIN), R5.2
TIRA1_DOUT: DS2.4 (DOUT), R8.1
TIRA2_DIN: DS3.2 (DIN), R8.2
TOUCH_CLK: DS1.34 (CLK), U1.32 (GPIO38)
TOUCH_CS: DS1.33 (T_CS), U1.29 (GPIO41)
TOUCH_MISO: DS1.29 (MISO), U1.38 (GPIO48)
TOUCH_MOSI: DS1.30 (MOSI), R9.1, U1.14 (GPIO46)
TOUCH_PEN: DS1.31 (PEN), U6.4 (GPB3)
VBAT_ADC: C2.1, R13.2, R14.1, U1.16 (GPIO10)
VBAT_CELDA: BT1.1 (+), BT2.1 (+), U2.3 (B+)
VBAT_PROT: SW4.1 (A), U2.5 (OUT+)
VBAT_SW: C5.1, L1.1, R13.1, SW4.2 (B), U3.4 (EN), U3.5 (IN)

Notes on the sheet:
MICROCONTROLADOR
R6/R9: pull-downs de arranque
(GPIO3, GPIO46). R10/R11: I2C.
LED de estado en GPIO43 (U0TXD),
activo en alto, ~3.6 mA.
Pantalla en bus 8080 de 16 bits (LCD_CAM). Touch XPT2046 por SPI. Teclado, switches, boton, PEN y BL en el expansor U6 por I2C.
GPIO35-37 los usa la PSRAM octal. GPIO19/20 son el USB nativo. GPIO43 (U0TXD) maneja D5; GPIO44 libre (puente USB-UART).
GPIO0, GPIO45 y GPIO46 son pines de arranque: solo cargas de alta impedancia; GPIO46 (MOSI) lleva R9 a GND, sin pull-up.
LED RGB de la tarjeta: GPIO38 en v1.1 (lleva TOUCH_CLK, en reposo bajo, el LED no enciende), GPIO48 en v1.0.
GPIO45 no debe llevar pull-up: en alto el arranque fija la flash a 1.8 V. Las dos tiras van encadenadas en GPIO3.
PANTALLA TFT 3.5in, BUS DE 16 BITS, TOUCH SPI
Pin 1 = CS (fila de arriba, izquierda).
Impares arriba, pares abajo.
El modulo solo acepta bus de 16 bits.
CS a GND: unico dispositivo en el bus.
RD fijo en alto con R1 (solo escritura).
RST al EN de la tarjeta (reset comun).
VDD (24, 25) a 3V3 del DevKit: sirve con
J1 del modulo abierto o en corto.
5V (28) es BL_VDD, sin conectar: la
retroiluminacion toma 3.3 V por R5.
BL alto = encendida (U6 GPB4).
SDCS (22) y F_CS (32) a 3V3: microSD y
flash comparten el SPI y quedan fuera.
PEN (31) al expansor U6 (GPB3).
Logica a 3.3 V, sin traslador.
EXPANSOR I2C Y TECLADO 4x4
U6 en 0x20 (A0-A2 a GND). R17-R20: pull-ups de KEY_C1-C4.
ENTRADAS: SWITCHES Y PUSH BUTTON
Pull-ups externos de 10k por los cables largos en campo. C1 filtra el rebote del boton (tau = 1 ms).
Switch cerrado = nivel bajo. SW1 abierto = equipo rojo, cerrado = equipo azul. Se leen en U6 (GPB0 a GPB2).
SALIDAS: TIRAS LED RGB Y AUDIO
Tiras WS2812B de 5 V encadenadas en una sola linea (GPIO3, RMT): LEDs 0-14 en DS2, 15-29 en DS3. U5 sube el dato a 5 V. C7 junto a U5.
R5 junto a DIN de DS2, R8 entre DOUT de DS2 y DIN de DS3. C8 junto a las tiras. R6 (bloque del micro) mantiene el dato en bajo al arrancar.
Supuesto: 15 LEDs por tira (25 cm de tira de 60 LEDs/m). Hasta 0.9 A por tira en blanco; el firmware limita las dos a 600 mA en total.
Audio: MAX98357A por I2S, 3.2 W en 4 ohm a 5 V. SD a 3V3 mezcla L+R, GAIN abierto = 9 dB. C3 y C4 junto al modulo.
ALIMENTACION (OPCION B): 1S2P 18650, CARGA USB-C, ELEVADOR A 5 V
Carga por el USB-C del TP4056 (IN+/IN- son su conector).
D4 es el diodo del elevador y bloquea el retorno del USB del DevKit.
R13/R14: 4.2 V de bateria -> 2.1 V en GPIO10 (ADC1).
Consumo estimado ~0.9 A de bateria con tiras al 50%:
unas 6.8 h nominales. Limitar tiras a 300 mA (MT3608).
MT3608: Vout = 0.6 V x (1 + R15/R16) = 5.2 V en el riel, con FB despues de D4.
EN a VIN. L1 con corriente de saturacion de 3 A o mas.
OPCION B: diseno discreto con TP4056, interruptor y MT3608 (alternativa a la opcion A).
