rodgutzal/Airsoft-MultipurposeGameModeTool/Hw/esquematico_v1/opcion_c/airsoft_tool_opcion_C.kicad_sch

## KiCad design Hw/esquematico_v1/opcion_c/airsoft_tool_opcion_C.kicad_sch (2026-11-12)

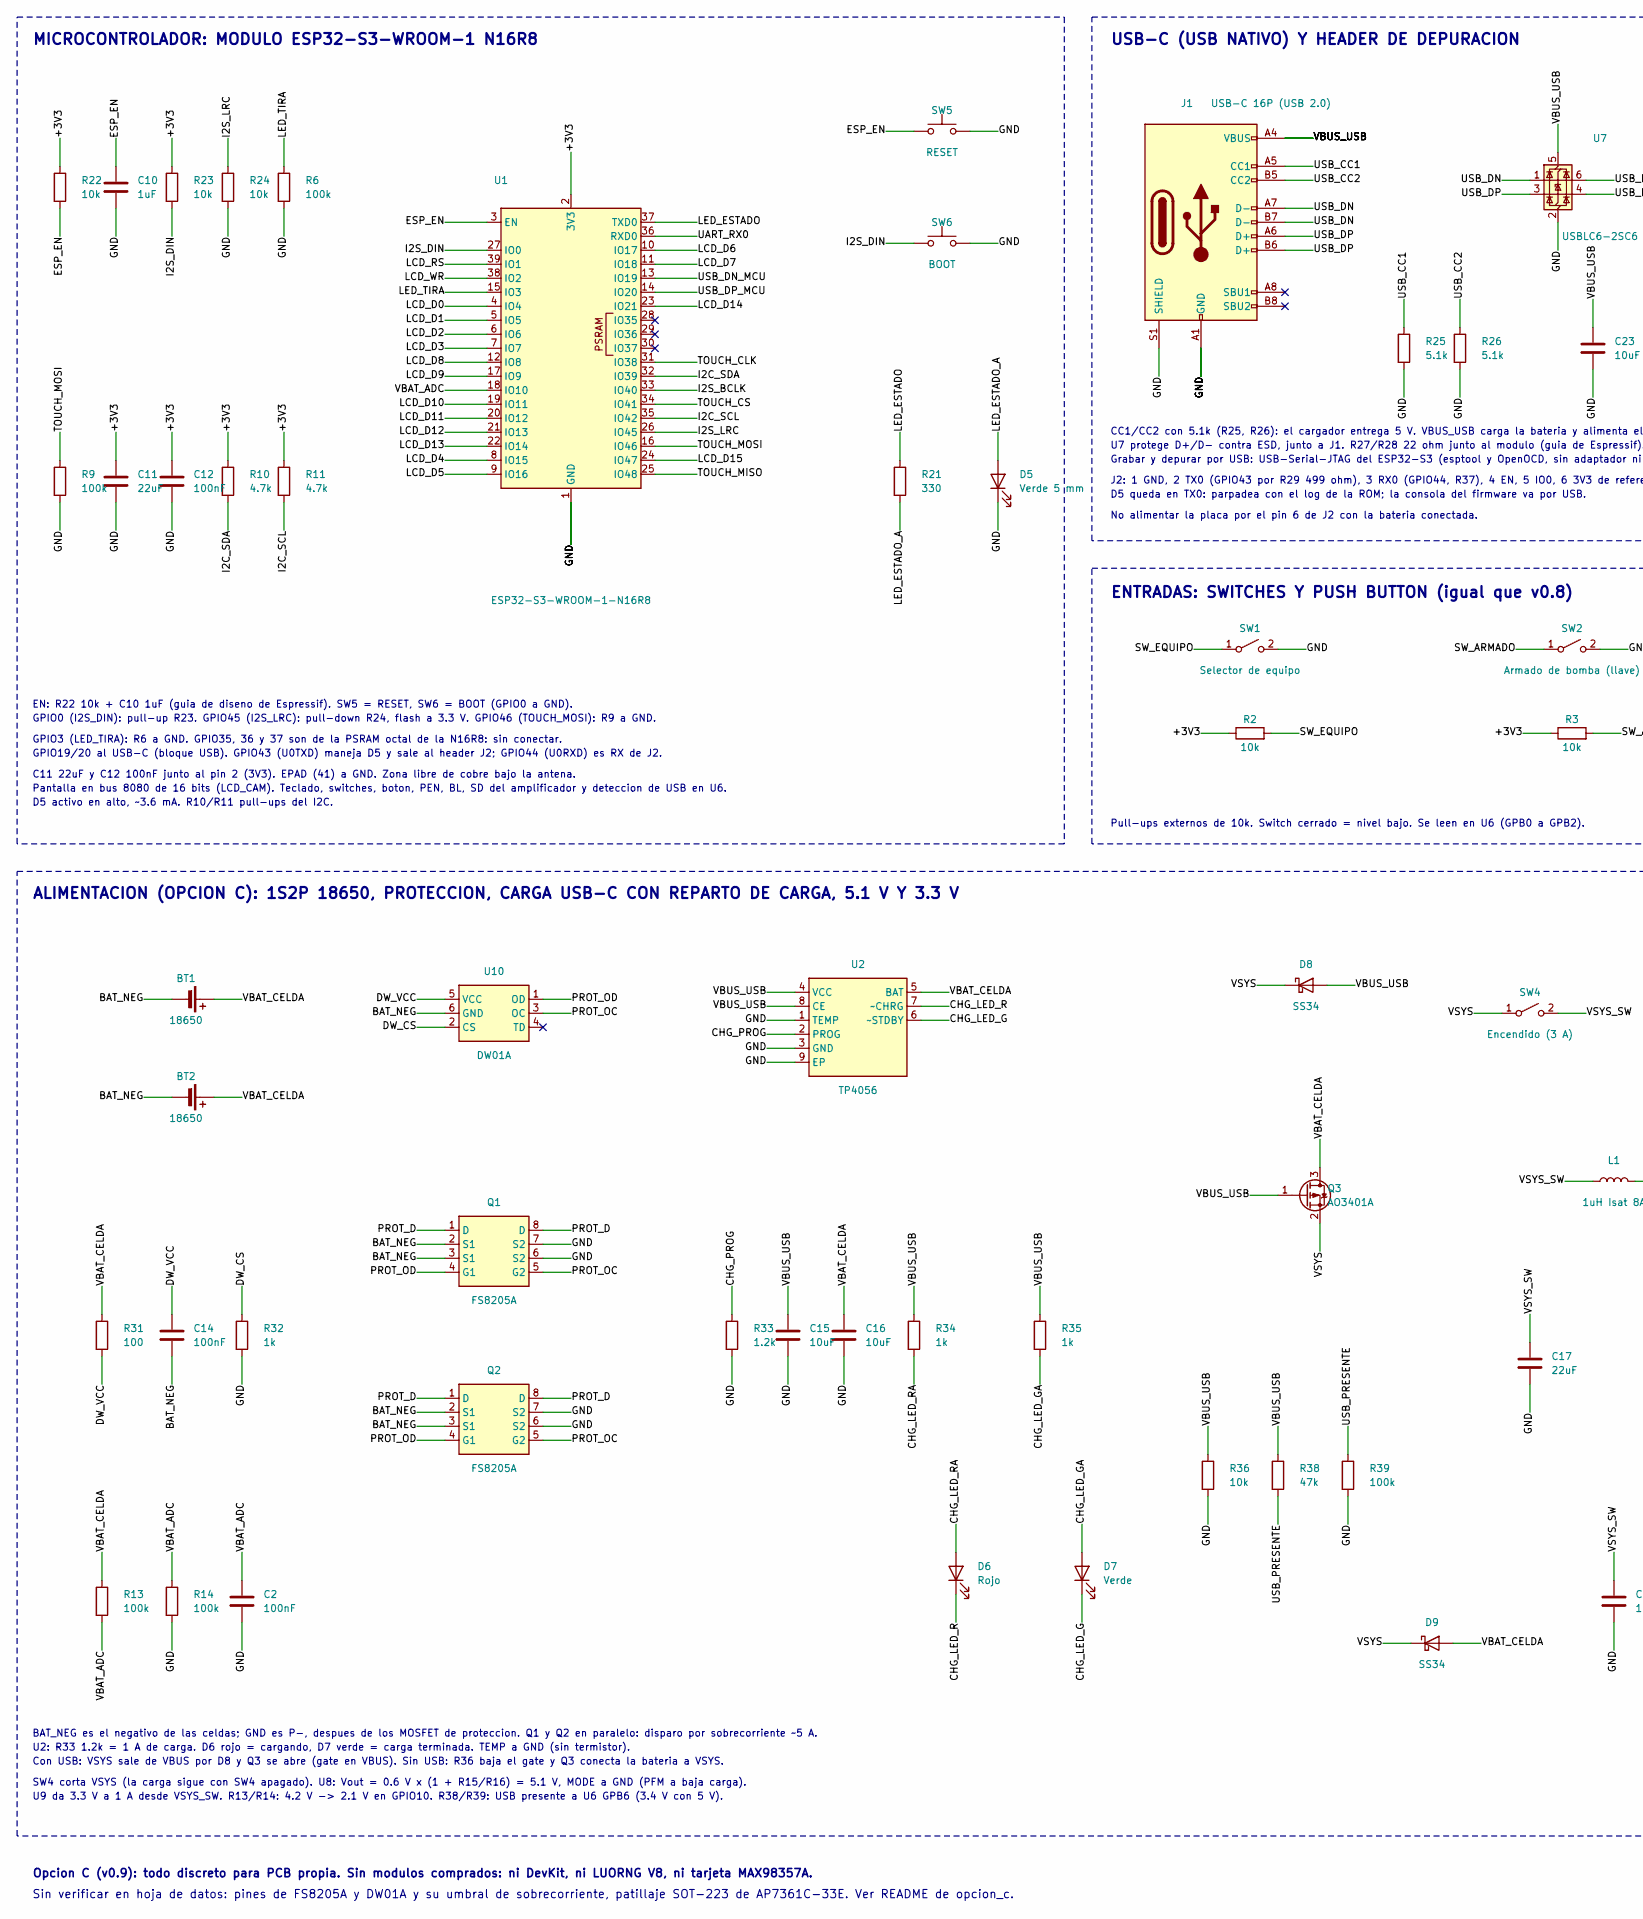
[picture p11: schematic airsoft_tool_opcion_C.kicad_sch, part in row 1, column 1]

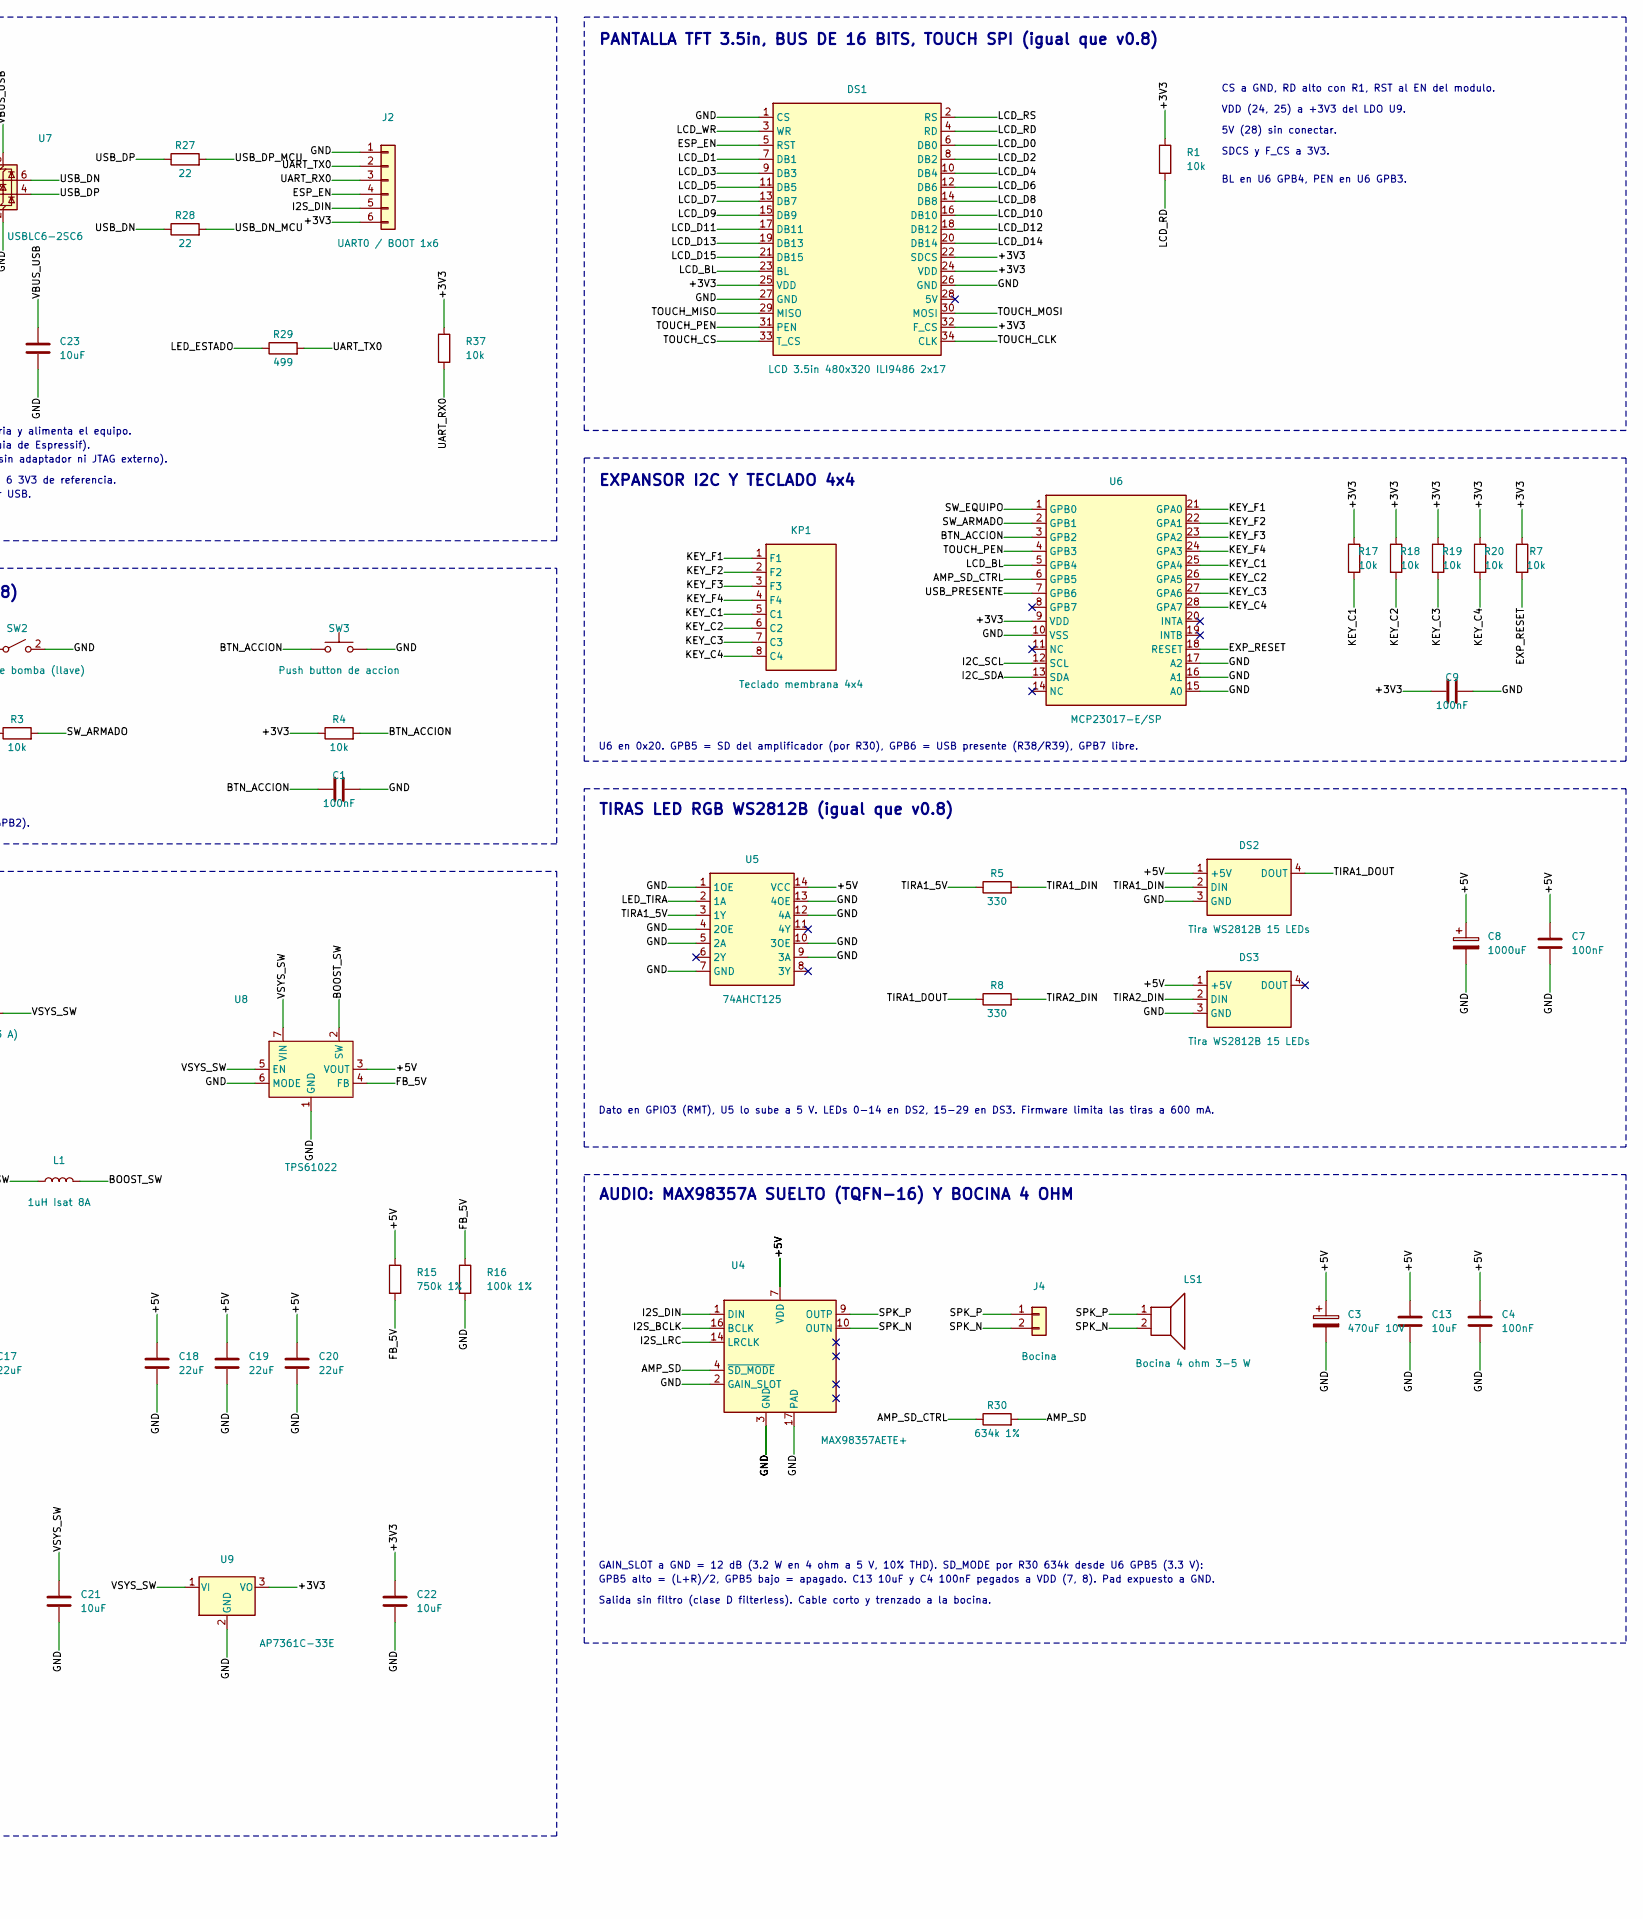
[picture p12: schematic airsoft_tool_opcion_C.kicad_sch, part in row 1, column 2]

Parts:
BT1, BT2: 18650; BatteryHolder_MPD_BH-18650-PC2
C1, C2, C4, C7, C9, C12, C14: 100nF; C_0603_1608Metric
C3: 470uF 10V; CP_Elec_8x10
C8: 1000uF; CP_Elec_10x10
C10: 1uF; C_0603_1608Metric
C11, C17, C18, C19, C20: 22uF; C_0805_2012Metric
C13, C15, C16, C21, C22, C23: 10uF; C_0805_2012Metric
D5: Verde 5 mm; LED_D5.0mm
D6: Rojo; LED_0805_2012Metric
D7: Verde; LED_0805_2012Metric
D8, D9: SS34; D_SMA
DS1: LCD 3.5in 480x320 ILI9486 2x17; PinSocket_2x17_P2.54mm_Vertical
DS2, DS3: Tira WS2812B 15 LEDs; JST_XH_B4B-XH-A_1x04_P2.50mm_Vertical
J1: USB-C 16P (USB 2.0); USB_C_Receptacle_HRO_TYPE-C-31-M-12
J2: UART0 / BOOT 1x6; PinHeader_1x06_P2.54mm_Vertical
J4: Bocina; JST_XH_B2B-XH-A_1x02_P2.50mm_Vertical
KP1: Teclado membrana 4x4; PinHeader_1x08_P2.54mm_Vertical
L1: 1uH Isat 8A; L_Coilcraft_XAL5030-XXX
LS1: Bocina 4 ohm 3-5 W
Q1, Q2: FS8205A; TSSOP-8_4.4x3mm_P0.65mm
Q3: AO3401A; SOT-23
R1, R2, R3, R4, R7, R17, R18, R19, R20, R22, R23, R24, R36, R37: 10k; R_0603_1608Metric
R5, R8, R21: 330; R_0603_1608Metric
R6, R9, R13, R14, R39: 100k; R_0603_1608Metric
R10, R11: 4.7k; R_0603_1608Metric
R15: 750k 1%; R_0603_1608Metric
R16: 100k 1%; R_0603_1608Metric
R25, R26: 5.1k; R_0603_1608Metric
R27, R28: 22; R_0603_1608Metric
R29: 499; R_0603_1608Metric
R30: 634k 1%; R_0603_1608Metric
R31: 100; R_0603_1608Metric
R32, R34, R35: 1k; R_0603_1608Metric
R33: 1.2k; R_0603_1608Metric
R38: 47k; R_0603_1608Metric
SW1: Selector de equipo; JST_XH_B2B-XH-A_1x02_P2.50mm_Vertical
SW2: Armado de bomba (llave); JST_XH_B2B-XH-A_1x02_P2.50mm_Vertical
SW3: Push button de accion; JST_XH_B2B-XH-A_1x02_P2.50mm_Vertical
SW4: Encendido (3 A); JST_XH_B2B-XH-A_1x02_P2.50mm_Vertical
SW5: RESET; SW_SPST_TL3342
SW6: BOOT; SW_SPST_TL3342
U1: ESP32-S3-WROOM-1-N16R8; ESP32-S3-WROOM-1
U2: TP4056; SOIC-8-1EP_3.9x4.9mm_P1.27mm_EP2.41x3.3mm_ThermalVias
U4: MAX98357AETE+; TQFN-16-1EP_3x3mm_P0.5mm_EP1.23x1.23mm_ThermalVias
U5: 74AHCT125; SOIC-14_3.9x8.7mm_P1.27mm
U6: MCP23017-E/SP; SOIC-28W_7.5x17.9mm_P1.27mm
U7: USBLC6-2SC6; SOT-23-6
U8: TPS61022; Texas_RWU0007A_VQFN-7_2x2mm_P0.5mm
U9: AP7361C-33E; SOT-223-3_TabPin2
U10: DW01A; SOT-23-6

Connections:
+3V3: C9.1, C11.1, C12.1, C22.1, DS1.22 (SDCS), DS1.24 (VDD), DS1.25 (VDD), DS1.32 (F_CS), J2.6, R1.1, R2.1, R3.1, R4.1, R7.1, R10.1, R11.1, R17.1, R18.1, R19.1, R20.1, R22.1, R23.1, R37.1, U1.2 (3V3), U6.9 (VDD), U9.3 (VO)
+5V: C3.1, C4.1, C7.1, C8.1, C13.1, C18.1, C19.1, C20.1, DS2.1 (+5V), DS3.1 (+5V), R15.1, U4.7 (VDD), U4.8 (VDD), U5.14 (VCC), U8.3 (VOUT)
AMP_SD: R30.2, U4.4 (~SD_MODE)
AMP_SD_CTRL: R30.1, U6.6 (GPB5)
BAT_NEG: BT1.2 (-), BT2.2 (-), C14.2, Q1.2 (S1), Q1.3 (S1), Q2.2 (S1), Q2.3 (S1), U10.6 (GND)
BOOST_SW: L1.2, U8.2 (SW)
BTN_ACCION: C1.1, R4.2, SW3.1, U6.3 (GPB2)
CHG_LED_G: D7.1 (K), U2.6 (~STDBY)
CHG_LED_GA: D7.2 (A), R35.2
CHG_LED_R: D6.1 (K), U2.7 (~CHRG)
CHG_LED_RA: D6.2 (A), R34.2
CHG_PROG: R33.1, U2.2 (PROG)
DW_CS: R32.1, U10.2 (CS)
DW_VCC: C14.1, R31.2, U10.5 (VCC)
ESP_EN: C10.1, DS1.5 (RST), J2.4, R22.2, SW5.1, U1.3 (EN)
EXP_RESET: R7.2, U6.18 (RESET)
FB_5V: R15.2, R16.1, U8.4 (FB)
GND: C1.2, C2.2, C3.2, C4.2, C7.2, C8.2, C9.2, C10.2, C11.2, C12.2, C13.2, C15.2, C16.2, C17.2, C18.2, C19.2, C20.2, C21.2, C22.2, C23.2, D5.1 (K), DS1.1 (CS), DS1.26 (GND), DS1.27 (GND), DS2.3 (GND), DS3.3 (GND), J1.A1 (GND), J1.A12 (GND), J1.B1 (GND), J1.B12 (GND), J1.S1 (SHIELD), J2.1, Q1.6 (S2), Q1.7 (S2), Q2.6 (S2), Q2.7 (S2), R6.2, R9.2, R14.2, R16.2, R24.2, R25.2, R26.2, R32.2, R33.2, R36.2, R39.2, SW1.2 (B), SW2.2 (B), SW3.2, SW5.2, SW6.2, U1.1 (GND), U1.40 (GND), U1.41 (GND), U2.1 (TEMP), U2.3 (GND), U2.9 (EP), U4.2 (GAIN_SLOT), U4.3 (GND), U4.11 (GND), U4.15 (GND), U4.17 (PAD), U5.1 (1OE), U5.4 (2OE), U5.5 (2A), U5.7 (GND), U5.9 (3A), U5.10 (3OE), U5.12 (4A), U5.13 (4OE), U6.10 (VSS), U6.15 (A0), U6.16 (A1), U6.17 (A2), U7.2 (GND), U8.1 (GND), U8.6 (MODE), U9.2 (GND)
I2C_SCL: R11.2, U1.35 (IO42), U6.12 (SCL)
I2C_SDA: R10.2, U1.32 (IO39), U6.13 (SDA)
I2S_BCLK: U1.33 (IO40), U4.16 (BCLK)
I2S_DIN: J2.5, R23.2, SW6.1, U1.27 (IO0), U4.1 (DIN)
I2S_LRC: R24.1, U1.26 (IO45), U4.14 (LRCLK)
KEY_C1: KP1.5 (C1), R17.2, U6.25 (GPA4)
KEY_C2: KP1.6 (C2), R18.2, U6.26 (GPA5)
KEY_C3: KP1.7 (C3), R19.2, U6.27 (GPA6)
KEY_C4: KP1.8 (C4), R20.2, U6.28 (GPA7)
KEY_F1: KP1.1 (F1), U6.21 (GPA0)
KEY_F2: KP1.2 (F2), U6.22 (GPA1)
KEY_F3: KP1.3 (F3), U6.23 (GPA2)
KEY_F4: KP1.4 (F4), U6.24 (GPA3)
LCD_BL: DS1.23 (BL), U6.5 (GPB4)
LCD_D0: DS1.6 (DB0), U1.4 (IO4)
LCD_D1: DS1.7 (DB1), U1.5 (IO5)
LCD_D2: DS1.8 (DB2), U1.6 (IO6)
LCD_D3: DS1.9 (DB3), U1.7 (IO7)
LCD_D4: DS1.10 (DB4), U1.8 (IO15)
LCD_D5: DS1.11 (DB5), U1.9 (IO16)
LCD_D6: DS1.12 (DB6), U1.10 (IO17)
LCD_D7: DS1.13 (DB7), U1.11 (IO18)
LCD_D8: DS1.14 (DB8), U1.12 (IO8)
LCD_D9: DS1.15 (DB9), U1.17 (IO9)
LCD_D10: DS1.16 (DB10), U1.19 (IO11)
LCD_D11: DS1.17 (DB11), U1.20 (IO12)
LCD_D12: DS1.18 (DB12), U1.21 (IO13)
LCD_D13: DS1.19 (DB13), U1.22 (IO14)
LCD_D14: DS1.20 (DB14), U1.23 (IO21)
LCD_D15: DS1.21 (DB15), U1.24 (IO47)
LCD_RD: DS1.4 (RD), R1.2
LCD_RS: DS1.2 (RS), U1.39 (IO1)
LCD_WR: DS1.3 (WR), U1.38 (IO2)
LED_ESTADO: R21.1, R29.1, U1.37 (TXD0)
LED_ESTADO_A: D5.2 (A), R21.2
LED_TIRA: R6.1, U1.15 (IO3), U5.2 (1A)
PROT_D: Q1.1 (D), Q1.8 (D), Q2.1 (D), Q2.8 (D)
PROT_OC: Q1.5 (G2), Q2.5 (G2), U10.3 (OC)
PROT_OD: Q1.4 (G1), Q2.4 (G1), U10.1 (OD)
SPK_N: J4.2, LS1.2, U4.10 (OUTN)
SPK_P: J4.1, LS1.1, U4.9 (OUTP)
SW_ARMADO: R3.2, SW2.1 (A), U6.2 (GPB1)
SW_EQUIPO: R2.2, SW1.1 (A), U6.1 (GPB0)
TIRA1_5V: R5.1, U5.3 (1Y)
TIRA1_DIN: DS2.2 (DIN), R5.2
TIRA1_DOUT: DS2.4 (DOUT), R8.1
TIRA2_DIN: DS3.2 (DIN), R8.2
TOUCH_CLK: DS1.34 (CLK), U1.31 (IO38)
TOUCH_CS: DS1.33 (T_CS), U1.34 (IO41)
TOUCH_MISO: DS1.29 (MISO), U1.25 (IO48)
TOUCH_MOSI: DS1.30 (MOSI), R9.1, U1.16 (IO46)
TOUCH_PEN: DS1.31 (PEN), U6.4 (GPB3)
UART_RX0: J2.3, R37.2, U1.36 (RXD0)
UART_TX0: J2.2, R29.2
USB_CC1: J1.A5 (CC1), R25.1
USB_CC2: J1.B5 (CC2), R26.1
USB_DN: J1.A7 (D-), J1.B7 (D-), R28.1, U7.1 (I/O1), U7.6 (I/O1)
USB_DN_MCU: R28.2, U1.13 (IO19)
USB_DP: J1.A6 (D+), J1.B6 (D+), R27.1, U7.3 (I/O2), U7.4 (I/O2)
USB_DP_MCU: R27.2, U1.14 (IO20)
USB_PRESENTE: R38.2, R39.1, U6.7 (GPB6)
VBAT_ADC: C2.1, R13.2, R14.1, U1.18 (IO10)
VBAT_CELDA: BT1.1 (+), BT2.1 (+), C16.1, D9.2 (A), Q3.3 (D), R13.1, R31.1, U2.5 (BAT)
VBUS_USB: C15.1, C23.1, D8.2 (A), J1.A4 (VBUS), J1.A9 (VBUS), J1.B4 (VBUS), J1.B9 (VBUS), Q3.1 (G), R34.1, R35.1, R36.1, R38.1, U2.4 (VCC), U2.8 (CE), U7.5 (VBUS)
VSYS: D8.1 (K), D9.1 (K), Q3.2 (S), SW4.1 (A)
VSYS_SW: C17.1, C21.1, L1.1, SW4.2 (B), U8.5 (EN), U8.7 (VIN), U9.1 (VI)

Notes on the sheet:
MICROCONTROLADOR: MODULO ESP32-S3-WROOM-1 N16R8
EN: R22 10k + C10 1uF (guia de diseno de Espressif). SW5 = RESET, SW6 = BOOT (GPIO0 a GND).
GPIO0 (I2S_DIN): pull-up R23. GPIO45 (I2S_LRC): pull-down R24, flash a 3.3 V. GPIO46 (TOUCH_MOSI): R9 a GND.
GPIO3 (LED_TIRA): R6 a GND. GPIO35, 36 y 37 son de la PSRAM octal de la N16R8: sin conectar.
GPIO19/20 al USB-C (bloque USB). GPIO43 (U0TXD) maneja D5 y sale al header J2; GPIO44 (U0RXD) es RX de J2.
C11 22uF y C12 100nF junto al pin 2 (3V3). EPAD (41) a GND. Zona libre de cobre bajo la antena.
Pantalla en bus 8080 de 16 bits (LCD_CAM). Teclado, switches, boton, PEN, BL, SD del amplificador y deteccion de USB en U6.
D5 activo en alto, ~3.6 mA. R10/R11 pull-ups del I2C.
USB-C (USB NATIVO) Y HEADER DE DEPURACION
CC1/CC2 con 5.1k (R25, R26): el cargador entrega 5 V. VBUS_USB carga la bateria y alimenta el equipo.
U7 protege D+/D- contra ESD, junto a J1. R27/R28 22 ohm junto al modulo (guia de Espressif).
Grabar y depurar por USB: USB-Serial-JTAG del ESP32-S3 (esptool y OpenOCD, sin adaptador ni JTAG externo).
J2: 1 GND, 2 TX0 (GPIO43 por R29 499 ohm), 3 RX0 (GPIO44, R37), 4 EN, 5 IO0, 6 3V3 de referencia.
D5 queda en TX0: parpadea con el log de la ROM; la consola del firmware va por USB.
No alimentar la placa por el pin 6 de J2 con la bateria conectada.
PANTALLA TFT 3.5in, BUS DE 16 BITS, TOUCH SPI (igual que v0.8)
CS a GND, RD alto con R1, RST al EN del modulo.
VDD (24, 25) a +3V3 del LDO U9.
5V (28) sin conectar.
SDCS y F_CS a 3V3.
BL en U6 GPB4, PEN en U6 GPB3.
EXPANSOR I2C Y TECLADO 4x4
U6 en 0x20. GPB5 = SD del amplificador (por R30), GPB6 = USB presente (R38/R39), GPB7 libre.
ENTRADAS: SWITCHES Y PUSH BUTTON (igual que v0.8)
Pull-ups externos de 10k. Switch cerrado = nivel bajo. Se leen en U6 (GPB0 a GPB2).
TIRAS LED RGB WS2812B (igual que v0.8)
Dato en GPIO3 (RMT), U5 lo sube a 5 V. LEDs 0-14 en DS2, 15-29 en DS3. Firmware limita las tiras a 600 mA.
AUDIO: MAX98357A SUELTO (TQFN-16) Y BOCINA 4 OHM
GAIN_SLOT a GND = 12 dB (3.2 W en 4 ohm a 5 V, 10% THD). SD_MODE por R30 634k desde U6 GPB5 (3.3 V):
GPB5 alto = (L+R)/2, GPB5 bajo = apagado. C13 10uF y C4 100nF pegados a VDD (7, 8). Pad expuesto a GND.
Salida sin filtro (clase D filterless). Cable corto y trenzado a la bocina.
ALIMENTACION (OPCION C): 1S2P 18650, PROTECCION, CARGA USB-C CON REPARTO DE CARGA, 5.1 V Y 3.3 V
BAT_NEG es el negativo de las celdas; GND es P-, despues de los MOSFET de proteccion. Q1 y Q2 en paralelo: disparo por sobrecorriente ~5 A.
U2: R33 1.2k = 1 A de carga. D6 rojo = cargando, D7 verde = carga terminada. TEMP a GND (sin termistor).
Con USB: VSYS sale de VBUS por D8 y Q3 se abre (gate en VBUS). Sin USB: R36 baja el gate y Q3 conecta la bateria a VSYS.
SW4 corta VSYS (la carga sigue con SW4 apagado). U8: Vout = 0.6 V x (1 + R15/R16) = 5.1 V, MODE a GND (PFM a baja carga).
U9 da 3.3 V a 1 A desde VSYS_SW. R13/R14: 4.2 V -> 2.1 V en GPIO10. R38/R39: USB presente a U6 GPB6 (3.4 V con 5 V).
Opcion C (v0.9): todo discreto para PCB propia. Sin modulos comprados: ni DevKit, ni LUORNG V8, ni tarjeta MAX98357A.
Sin verificar en hoja de datos: pines de FS8205A y DW01A y su umbral de sobrecorriente, patillaje SOT-223 de AP7361C-33E. Ver README de opcion_c.
