rodgutzal/Airsoft-MultipurposeGameModeTool/Hw/esquematico_v1/gen_sch.py

#!/usr/bin/env python3
"""Genera el esquemático v1 (KiCad 7) de la herramienta de airsoft.

Estilo: cada pin lleva un tramo corto de cable y una etiqueta de red.
La conectividad se da por nombre de etiqueta.
"""
import re
import sys
import uuid as _uuid

LIBDIR = "/usr/share/kicad/symbols"
VARIANT = (sys.argv[3] if len(sys.argv) > 3 else "A").upper()
assert VARIANT in ("A", "B")
PROJECT = "airsoft_tool"
G = 2.54


def uid():
    return str(_uuid.uuid4())


ROOT_UUID = uid()


# ---------------------------------------------------------------- librerías
def extract_lib_symbol(lib, name):
    t = open(f"{LIBDIR}/{lib}.kicad_sym").read()
    i = t.find(f'(symbol "{name}"')
    if i < 0:
        sys.exit(f"no existe {lib}:{name}")
    d = 0
    j = i
    while True:
        c = t[j]
        if c == "(":
            d += 1
        elif c == ")":
            d -= 1
            if d == 0:
                break
        j += 1
    s = t[i : j + 1]
    pins = {}
    for m in re.finditer(
        r'\(pin \w+ \w+ \(at ([-\d.]+) ([-\d.]+) (\d+)\) \(length [\d.]+\)[\s\S]*?\(name "([^"]*)"[\s\S]*?\(number "([^"]*)"',
        s,
    ):
        x, y, a, _n, num = m.groups()
        pins[num] = (float(x), float(y), int(a))
    s = s.replace(f'(symbol "{name}"', f'(symbol "{lib}:{name}"', 1)
    return s, pins


def box_symbol(name, ref, left, right, width=25.4, desc=""):
    """Símbolo rectangular con pines pasivos. left/right: listas de (num, nombre)."""
    n = max(len(left), len(right))
    top = (n - 1) / 2 * G
    hw = width / 2
    pins = {}
    body = []
    for side, lst in (("L", left), ("R", right)):
        for i, (num, pname) in enumerate(lst):
            y = round(top - i * G, 2)
            if side == "L":
                x, a = -(hw + G), 0
            else:
                x, a = hw + G, 180
            pins[num] = (x, y, a)
            body.append(
                f'(pin passive line (at {x} {y} {a}) (length {G}) '
                f'(name "{pname}" (effects (font (size 1.27 1.27)))) '
                f'(number "{num}" (effects (font (size 1.27 1.27)))))'
            )
    ytop = top + G
    ybot = -top - G
    s = (
        f'(symbol "custom:{name}" (in_bom yes) (on_board yes)\n'
        f'  (property "Reference" "{ref}" (at 0 {ytop + 1.27} 0) (effects (font (size 1.27 1.27))))\n'
        f'  (property "Value" "{name}" (at 0 {ybot - 1.27} 0) (effects (font (size 1.27 1.27))))\n'
        f'  (property "Footprint" "" (at 0 0 0) (effects (font (size 1.27 1.27)) hide))\n'
        f'  (property "Datasheet" "" (at 0 0 0) (effects (font (size 1.27 1.27)) hide))\n'
        f'  (property "Description" "{desc}" (at 0 0 0) (effects (font (size 1.27 1.27)) hide))\n'
        f'  (symbol "{name}_0_1" (rectangle (start {-hw} {ytop}) (end {hw} {ybot}) '
        f'(stroke (width 0.254) (type default)) (fill (type background))))\n'
        f'  (symbol "{name}_1_1" {" ".join(body)})\n)'
    )
    return s, pins


LIB = {}  # lib_id -> (texto, pines)


def use_std(lib, name):
    lid = f"{lib}:{name}"
    if lid not in LIB:
        LIB[lid] = extract_lib_symbol(lib, name)
    return lid


def use_box(name, ref, left, right, width=25.4, desc=""):
    lid = f"custom:{name}"
    LIB[lid] = box_symbol(name, ref, left, right, width, desc)
    return lid


# ---------------------------------------------------------------- dibujo
ITEMS = []
BOM = []


def snap(v):
    return round(round(v / 1.27) * 1.27, 2)


def place(lid, ref, value, x, y, nets, stub=5.08, rot=0, fields=None, ref_at=None, val_at=None):
    """Coloca un símbolo y pone tramo + etiqueta en cada pin.
    nets: {num_pin: nombre_red | None (= no conectado)}"""
    x, y = snap(x), snap(y)
    _txt, pins = LIB[lid]
    rj = vj = "(justify left)"
    if ref_at is None and lid.startswith("custom:"):
        top = max(p[1] for p in pins.values()) + G
        ref_at = (0, -(top + 2.54)); val_at = (0, top + 2.54)
        rj = vj = ""
    if lid.endswith("Q_NMOS_GSD") and ref_at is None:
        ref_at = (6.35, -1.27); val_at = (6.35, 1.27)
    if ref_at is not None and len(ref_at) == 3:
        rj = vj = ""; ref_at = ref_at[:2]; val_at = val_at[:2]
    fa = (360 - rot) % 360
    ref_at = ref_at or (3.81, -1.27)
    val_at = val_at or (3.81, 1.27)
    pin_uuids = " ".join(f'(pin "{n}" (uuid {uid()}))' for n in pins)
    extra = ""
    for k, v in (fields or {}).items():
        extra += f'  (property "{k}" "{v}" (at {x} {y} 0) (effects (font (size 1.27 1.27)) hide))\n'
    ITEMS.append(
        f'(symbol (lib_id "{lid}") (at {x} {y} {rot}) (unit 1) (in_bom yes) (on_board yes) (dnp no) (uuid {uid()})\n'
        f'  (property "Reference" "{ref}" (at {x + ref_at[0]} {y + ref_at[1]} {fa}) (effects (font (size 1.27 1.27)) {rj}))\n'
        f'  (property "Value" "{value}" (at {x + val_at[0]} {y + val_at[1]} {fa}) (effects (font (size 1.27 1.27)) {vj}))\n'
        f'  (property "Footprint" "" (at {x} {y} 0) (effects (font (size 1.27 1.27)) hide))\n'
        f'  (property "Datasheet" "" (at {x} {y} 0) (effects (font (size 1.27 1.27)) hide))\n'
        f"{extra}"
        f"  {pin_uuids}\n"
        f'  (instances (project "{PROJECT}" (path "/{ROOT_UUID}" (reference "{ref}") (unit 1))))\n)'
    )
    BOM.append((ref, value, lid, fields or {}))
    for num, (px, py, a) in pins.items():
        # rotación del símbolo (solo 0 y 90 usados)
        if rot == 90:
            px, py, a = -py, px, (a + 90) % 360
        elif rot == 270:
            px, py, a = py, -px, (a + 270) % 360
        sx, sy = x + px, y - py  # el eje Y de la librería apunta hacia arriba
        # dirección del tramo: opuesta a la dirección hacia el cuerpo
        d = {0: (-1, 0), 90: (0, 1), 180: (1, 0), 270: (0, -1)}[a]
        net = nets.get(num, "__NC__")
        if net is None or net == "__NC__":
            if net == "__NC__" and num not in nets:
                print(f"aviso: {ref} pin {num} sin asignar", file=sys.stderr)
            ITEMS.append(f"(no_connect (at {round(sx,2)} {round(sy,2)}) (uuid {uid()}))")
            continue
        ex, ey = round(sx + d[0] * stub, 2), round(sy + d[1] * stub, 2)
        ITEMS.append(
            f"(wire (pts (xy {round(sx,2)} {round(sy,2)}) (xy {ex} {ey})) "
            f"(stroke (width 0) (type default)) (uuid {uid()}))"
        )
        la = {(-1, 0): 180, (1, 0): 0, (0, 1): 270, (0, -1): 90}[d]
        just = "right" if la in (180, 270) else "left"
        ITEMS.append(
            f'(label "{net}" (at {ex} {ey} {la}) (fields_autoplaced) '
            f"(effects (font (size 1.27 1.27)) (justify {just})) (uuid {uid()}))"
        )


def text(s, x, y, size=1.27, bold=False):
    s = s.replace('"', "'")
    b = " bold" if bold else ""
    ITEMS.append(
        f'(text "{s}" (at {snap(x)} {snap(y)} 0) '
        f"(effects (font (size {size} {size}){b}) (justify left)) (uuid {uid()}))"
    )


def frame(x1, y1, x2, y2):
    ITEMS.append(
        f"(rectangle (start {x1} {y1}) (end {x2} {y2}) "
        f"(stroke (width 0.2) (type dash)) (fill (type none)) (uuid {uid()}))"
    )


# ---------------------------------------------------------------- símbolos
R = use_std("Device", "R")
C = use_std("Device", "C")
LED = use_std("Device", "LED")
D = use_std("Device", "D")
Q = use_std("Device", "Q_NMOS_GSD")
SPK = use_std("Device", "Speaker")
CP = use_std("Device", "C_Polarized")
IND = use_std("Device", "L")
MT = use_std("Regulator_Switching", "MT3608")
BAT = use_std("Device", "Battery_Cell")
SPST = use_std("Switch", "SW_SPST")
PUSH = use_std("Switch", "SW_Push")

J1 = ["3V3", "3V3", "RST", "GPIO4", "GPIO5", "GPIO6", "GPIO7", "GPIO15", "GPIO16", "GPIO17",
      "GPIO18", "GPIO8", "GPIO3", "GPIO46", "GPIO9", "GPIO10", "GPIO11", "GPIO12", "GPIO13",
      "GPIO14", "5V", "GND"]
J3 = ["GND", "GPIO43_TX", "GPIO44_RX", "GPIO1", "GPIO2", "GPIO42", "GPIO41", "GPIO40", "GPIO39",
      "GPIO38", "GPIO37", "GPIO36", "GPIO35", "GPIO0", "GPIO45", "GPIO48", "GPIO47", "GPIO21",
      "GPIO20", "GPIO19", "GND", "GND"]
MOD = use_box("LUORNG_V8_2x18650", "M",
              [("1", "BAT+"), ("2", "BAT-")],
              [("3", "5V OUT"), ("4", "GND"), ("5", "3V OUT")],
              width=25.4, desc="Shield LUORNG V8 para 2 celdas 18650 en paralelo, carga USB-C o micro USB, salidas 5 V 2.2 A y 3 V 1 A")
MCU = use_box(
    "ESP32-S3-DevKitC-1_N16R8", "U",
    [(str(i + 1), n) for i, n in enumerate(J1)],
    [(str(i + 23), n) for i, n in enumerate(J3)],
    width=30.48, desc="Tarjeta ESP32-S3-DevKitC-1 v1.1, headers J1 (izq) y J3 (der)",
)
# Conector 2x17 del modulo "3.5' LCD MODULE" (serigrafia de la foto de Roy, 8 nov 2026).
# Pines impares en la fila de arriba, pares en la de abajo; pin 1 = CS a la izquierda.
TFT_PINS = ["CS", "RS", "WR", "RD", "RST"] + [f"DB{i}" for i in range(16)] + [
    "SDCS", "BL", "VDD", "VDD", "GND", "GND", "5V", "MISO", "MOSI", "PEN", "F_CS", "T_CS", "CLK"]
assert len(TFT_PINS) == 34
TFT = use_box(
    "LCD_3.5in_ILI9486_16bit_34p", "DS",
    [(str(n), TFT_PINS[n - 1]) for n in range(1, 35, 2)],
    [(str(n), TFT_PINS[n - 1]) for n in range(2, 35, 2)],
    width=30.48, desc="Modulo TFT 3.5in 480x320 ILI9486, bus 8080 de 16 bits, touch XPT2046 por SPI, conector 2x17",
)
EXP = use_box(
    "MCP23017_SP", "U",
    [(str(n), f"GPB{n - 1}") for n in range(1, 9)] + [("9", "VDD"), ("10", "VSS"), ("11", "NC"),
     ("12", "SCL"), ("13", "SDA"), ("14", "NC")],
    [(str(n), f"GPA{n - 21}") for n in range(21, 29)] + [("20", "INTA"), ("19", "INTB"), ("18", "RESET"),
     ("17", "A2"), ("16", "A1"), ("15", "A0")],
    width=25.4, desc="Expansor de 16 E/S por I2C, DIP-28, 3.3 V",
)
KEY = use_box("Teclado_4x4", "KP",
              [(str(i + 1), f"F{i+1}") for i in range(4)] + [(str(i + 5), f"C{i+1}") for i in range(4)],
              [], width=12.7, desc="Teclado matricial de membrana 4x4")
CHG = use_box("TP4056_USB-C_con_proteccion", "U",
              [("1", "IN+"), ("2", "IN-")],
              [("3", "B+"), ("4", "B-"), ("5", "OUT+"), ("6", "OUT-")],
              width=20.32, desc="Modulo cargador TP4056 + DW01 + FS8205")
BUF = use_box("74AHCT125", "U",
              [("1", "1OE"), ("2", "1A"), ("3", "1Y"), ("4", "2OE"), ("5", "2A"), ("6", "2Y"), ("7", "GND")],
              [("14", "VCC"), ("13", "4OE"), ("12", "4A"), ("11", "4Y"), ("10", "3OE"), ("9", "3A"), ("8", "3Y")],
              width=15.24, desc="Cuatro buffers con entrada TTL (VIH 2 V) alimentados a 5 V, DIP-14 (SN74AHCT125N)")
TIRA = use_box("Tira_WS2812B", "DS",
               [("1", "+5V"), ("2", "DIN"), ("3", "GND")], [("4", "DOUT")],
               width=15.24, desc="Tira LED RGB direccionable WS2812B 5 V")
AMP = use_box("MAX98357A_I2S_3W", "U",
              [("1", "VIN"), ("2", "GND"), ("3", "SD"), ("4", "GAIN"), ("5", "DIN"), ("6", "BCLK"), ("7", "LRC")],
              [("8", "OUT+"), ("9", "OUT-")],
              width=20.32, desc="Modulo amplificador I2S clase D MAX98357A, 3.2 W en 4 ohm a 5 V")

# ---------------------------------------------------------------- microcontrolador
mcu_nets = {
    "1": "+3V3", "2": "+3V3", "3": "ESP_EN",
    "4": "LCD_D0", "5": "LCD_D1", "6": "LCD_D2", "7": "LCD_D3", "8": "LCD_D4", "9": "LCD_D5",
    "10": "LCD_D6", "11": "LCD_D7", "12": "LCD_D8", "13": "LED_TIRA", "14": "TOUCH_MOSI",
    "15": "LCD_D9", "16": "VBAT_ADC", "17": "LCD_D10", "18": "LCD_D11", "19": "LCD_D12",
    "20": "LCD_D13", "21": "+5V", "22": "GND",
    "23": "GND", "24": "LED_ESTADO", "25": None, "26": "LCD_RS", "27": "LCD_WR", "28": "I2C_SCL",
    "29": "TOUCH_CS", "30": "I2S_BCLK", "31": "I2C_SDA", "32": "TOUCH_CLK", "33": None, "34": None,
    "35": None, "36": "I2S_DIN", "37": "I2S_LRC", "38": "TOUCH_MISO", "39": "LCD_D15",
    "40": "LCD_D14", "41": None, "42": None, "43": "GND", "44": "GND",
}
frame(10, 25, 215, 128)
text("MICROCONTROLADOR", 83, 29, 2, True)
place(MCU, "U1", "ESP32-S3-DevKitC-1 N16R8", 147.32, 76.2, mcu_nets, stub=7.62)
place(R, "R6", "100k", 27.94, 76.2, {"1": "LED_TIRA", "2": "GND"})
place(R, "R9", "100k", 45.72, 76.2, {"1": "TOUCH_MOSI", "2": "GND"})
place(R, "R10", "4.7k", 66.04, 76.2, {"1": "+3V3", "2": "I2C_SDA"})
place(R, "R11", "4.7k", 83.82, 76.2, {"1": "+3V3", "2": "I2C_SCL"})
text("R6/R9: pull-downs de arranque", 15, 92)
text("(GPIO3, GPIO46). R10/R11: I2C.", 15, 95)
place(R, "R21", "330", 35.56, 45.72, {"1": "LED_ESTADO", "2": "LED_ESTADO_A"}, rot=90, ref_at=(0, -2.54, 1), val_at=(0, 2.54, 1))
place(LED, "D5", "Verde 5 mm", 76.2, 45.72, {"1": "GND", "2": "LED_ESTADO_A"}, ref_at=(0, -3.81, 1), val_at=(0, 3.81, 1))
text("LED de estado en GPIO43 (U0TXD),", 55, 55)
text("activo en alto, ~3.6 mA.", 55, 58)
text("Pantalla en bus 8080 de 16 bits (LCD_CAM). Touch XPT2046 por SPI. Teclado, switches, boton, PEN y BL en el expansor U6 por I2C.", 83, 112)
text("GPIO35-37 los usa la PSRAM octal. GPIO19/20 son el USB nativo. GPIO43 (U0TXD) maneja D5; GPIO44 libre (puente USB-UART).", 83, 115)
text("GPIO0, GPIO45 y GPIO46 son pines de arranque: solo cargas de alta impedancia; GPIO46 (MOSI) lleva R9 a GND, sin pull-up.", 83, 118)
text("LED RGB de la tarjeta: GPIO38 en v1.1 (lleva TOUCH_CLK, en reposo bajo, el LED no enciende), GPIO48 en v1.0.", 83, 121)
text("GPIO45 no debe llevar pull-up: en alto el arranque fija la flash a 1.8 V. Las dos tiras van encadenadas en GPIO3.", 83, 124)

# ---------------------------------------------------------------- pantalla
frame(225, 25, 405, 95)
text("PANTALLA TFT 3.5in, BUS DE 16 BITS, TOUCH SPI", 228, 29, 2, True)
tft_nets = {"1": "GND", "2": "LCD_RS", "3": "LCD_WR", "4": "LCD_RD", "5": "ESP_EN"}
tft_nets.update({str(6 + i): f"LCD_D{i}" for i in range(16)})
tft_nets.update({"22": "+3V3", "23": "LCD_BL", "24": "+3V3", "25": "+3V3", "26": "GND", "27": "GND",
                 "28": None, "29": "TOUCH_MISO", "30": "TOUCH_MOSI", "31": "TOUCH_PEN", "32": "+3V3",
                 "33": "TOUCH_CS", "34": "TOUCH_CLK"})
place(TFT, "DS1", "LCD 3.5in 480x320 ILI9486 2x17", 275.0, 60.96, tft_nets, stub=7.62)
place(R, "R1", "10k", 330.2, 50.8, {"1": "+3V3", "2": "LCD_RD"})
text("Pin 1 = CS (fila de arriba, izquierda).", 340, 36)
text("Impares arriba, pares abajo.", 340, 39)
text("El modulo solo acepta bus de 16 bits.", 340, 44)
text("CS a GND: unico dispositivo en el bus.", 340, 47)
text("RD fijo en alto con R1 (solo escritura).", 340, 50)
text("RST al EN de la tarjeta (reset comun).", 340, 53)
text("VDD (24, 25) a 3V3 del DevKit: sirve con", 340, 58)
text("J1 del modulo abierto o en corto.", 340, 61)
text("5V (28) es BL_VDD, sin conectar: la", 340, 64)
text("retroiluminacion toma 3.3 V por R5.", 340, 67)
text("BL alto = encendida (U6 GPB4).", 340, 70)
text("SDCS (22) y F_CS (32) a 3V3: microSD y", 340, 75)
text("flash comparten el SPI y quedan fuera.", 340, 78)
text("PEN (31) al expansor U6 (GPB3).", 340, 81)
text("Logica a 3.3 V, sin traslador.", 340, 86)

# ---------------------------------------------------------------- teclado
frame(225, 100, 405, 150)
text("EXPANSOR I2C Y TECLADO 4x4", 228, 104, 2, True)
place(KEY, "KP1", "Teclado membrana 4x4", 264.16, 127.0,
      {"1": "KEY_F1", "2": "KEY_F2", "3": "KEY_F3", "4": "KEY_F4",
       "5": "KEY_C1", "6": "KEY_C2", "7": "KEY_C3", "8": "KEY_C4"})
exp_nets = {"1": "SW_EQUIPO", "2": "SW_ARMADO", "3": "BTN_ACCION", "4": "TOUCH_PEN", "5": "LCD_BL",
            "6": None, "7": None, "8": None, "9": "+3V3", "10": "GND", "11": None, "12": "I2C_SCL",
            "13": "I2C_SDA", "14": None, "15": "GND", "16": "GND", "17": "GND", "18": "EXP_RESET",
            "19": None, "20": None}
exp_nets.update({str(21 + i): f"KEY_F{i + 1}" for i in range(4)})
exp_nets.update({str(25 + i): f"KEY_C{i + 1}" for i in range(4)})
place(EXP, "U6", "MCP23017-E/SP", 322.58, 125.73, exp_nets, stub=5.08)
for i, (rr, col) in enumerate((("R17", "KEY_C1"), ("R18", "KEY_C2"), ("R19", "KEY_C3"), ("R20", "KEY_C4"), ("R7", "EXP_RESET"))):
    place(R, rr, "10k", 365.76 + i * 7.62, 118.11, {"1": "+3V3", "2": col}, ref_at=(2.54, -1.27, 1), val_at=(2.54, 1.27, 1))
place(C, "C9", "100nF", 381.0, 142.24, {"1": "+3V3", "2": "GND"}, rot=90, ref_at=(0, -2.54, 1), val_at=(0, 2.54, 1))
text("U6 en 0x20 (A0-A2 a GND). R17-R20: pull-ups de KEY_C1-C4.", 228, 147)

# ---------------------------------------------------------------- entradas de usuario
frame(10, 135, 215, 200)
text("ENTRADAS: SWITCHES Y PUSH BUTTON", 13, 139, 2, True)
H = ((0, -3.81, 1), (0, 3.81, 1))
place(SPST, "SW1", "Selector de equipo", 45.72, 149.86, {"1": "SW_EQUIPO", "2": "GND"}, ref_at=H[0], val_at=H[1])
place(R, "R2", "10k", 45.72, 170.18, {"1": "+3V3", "2": "SW_EQUIPO"})
place(SPST, "SW2", "Armado de bomba (llave)", 106.68, 149.86, {"1": "SW_ARMADO", "2": "GND"}, ref_at=H[0], val_at=H[1])
place(R, "R3", "10k", 106.68, 170.18, {"1": "+3V3", "2": "SW_ARMADO"})
place(PUSH, "SW3", "Push button de accion", 167.64, 149.86, {"1": "BTN_ACCION", "2": "GND"}, ref_at=H[0], val_at=H[1])
place(R, "R4", "10k", 162.56, 170.18, {"1": "+3V3", "2": "BTN_ACCION"})
place(C, "C1", "100nF", 185.42, 170.18, {"1": "BTN_ACCION", "2": "GND"})
text("Pull-ups externos de 10k por los cables largos en campo. C1 filtra el rebote del boton (tau = 1 ms).", 13, 192)
text("Switch cerrado = nivel bajo. SW1 abierto = equipo rojo, cerrado = equipo azul. Se leen en U6 (GPB0 a GPB2).", 13, 195)

# ---------------------------------------------------------------- salidas
frame(225, 155, 405, 253)
text("SALIDAS: TIRAS LED RGB Y AUDIO", 228, 159, 2, True)
place(BUF, "U5", "74AHCT125", 262.89, 180.34,
      {"1": "GND", "2": "LED_TIRA", "3": "TIRA1_5V", "4": "GND", "5": "GND", "6": None,
       "7": "GND", "8": None, "9": "GND", "10": "GND", "11": None, "12": "GND", "13": "GND", "14": "+5V"})
place(R, "R5", "330", 309.88, 172.72, {"1": "TIRA1_5V", "2": "TIRA1_DIN"}, rot=90, ref_at=(0, -2.54, 1), val_at=(0, 2.54, 1))
place(R, "R8", "330", 309.88, 193.04, {"1": "TIRA1_DOUT", "2": "TIRA2_DIN"}, rot=90, ref_at=(0, -2.54, 1), val_at=(0, 2.54, 1))
place(TIRA, "DS2", "Tira WS2812B 15 LEDs", 360.68, 172.72, {"1": "+5V", "2": "TIRA1_DIN", "3": "GND", "4": "TIRA1_DOUT"})
place(TIRA, "DS3", "Tira WS2812B 15 LEDs", 360.68, 193.04, {"1": "+5V", "2": "TIRA2_DIN", "3": "GND", "4": None})
place(CP, "C8", "1000uF", 377.19, 182.88, {"1": "+5V", "2": "GND"})
place(C, "C7", "100nF", 392.43, 182.88, {"1": "+5V", "2": "GND"})
text("Tiras WS2812B de 5 V encadenadas en una sola linea (GPIO3, RMT): LEDs 0-14 en DS2, 15-29 en DS3. U5 sube el dato a 5 V. C7 junto a U5.", 228, 207)
text("R5 junto a DIN de DS2, R8 entre DOUT de DS2 y DIN de DS3. C8 junto a las tiras. R6 (bloque del micro) mantiene el dato en bajo al arrancar.", 228, 210)
text("Supuesto: 15 LEDs por tira (25 cm de tira de 60 LEDs/m). Hasta 0.9 A por tira en blanco; el firmware limita las dos a 600 mA en total.", 228, 213)
place(AMP, "U4", "MAX98357A I2S", 262.89, 232.41,
      {"1": "+5V", "2": "GND", "3": "+3V3", "4": None, "5": "I2S_DIN", "6": "I2S_BCLK", "7": "I2S_LRC",
       "8": "SPK_P", "9": "SPK_N"})
place(SPK, "LS1", "Bocina 4 ohm 3-5 W", 315.0, 232.41, {"1": "SPK_P", "2": "SPK_N"},
      ref_at=(2.54, -6.35, 1), val_at=(2.54, 8.89, 1))
place(CP, "C3", "470uF 10V", 348.0, 232.41, {"1": "+5V", "2": "GND"})
place(C, "C4", "100nF", 364.0, 232.41, {"1": "+5V", "2": "GND"})
text("Audio: MAX98357A por I2S, 3.2 W en 4 ohm a 5 V. SD a 3V3 mezcla L+R, GAIN abierto = 9 dB. C3 y C4 junto al modulo.", 228, 249)

# ---------------------------------------------------------------- alimentación
if VARIANT == "B":
    frame(10, 205, 215, 285)
    text("ALIMENTACION (OPCION B): 1S2P 18650, CARGA USB-C, ELEVADOR A 5 V", 13, 209, 2, True)
    place(BAT, "BT1", "18650", 33.02, 223.52, {"1": "VBAT_CELDA", "2": "BAT_NEG"}, rot=270, ref_at=(0, -3.81, 1), val_at=(0, 3.81, 1))
    place(BAT, "BT2", "18650", 33.02, 236.22, {"1": "VBAT_CELDA", "2": "BAT_NEG"}, rot=270, ref_at=(0, -3.81, 1), val_at=(0, 3.81, 1))
    place(CHG, "U2", "TP4056 USB-C con proteccion", 81.28, 231.14,
          {"1": None, "2": None, "3": "VBAT_CELDA", "4": "BAT_NEG", "5": "VBAT_PROT", "6": "GND"})
    place(SPST, "SW4", "Encendido", 132.08, 220.98, {"1": "VBAT_PROT", "2": "VBAT_SW"}, ref_at=H[0], val_at=H[1])
    place(MT, "U3", "MT3608", 180.34, 222.25,
          {"1": "SW_BOOST", "2": "GND", "3": "FB_5V", "4": "VBAT_SW", "5": "VBAT_SW", "6": None},
          ref_at=(0, -12.7, 1), val_at=(0, -10.16, 1))
    place(C, "C5", "22uF 10V", 112.0, 245.0, {"1": "VBAT_SW", "2": "GND"})
    place(IND, "L1", "22uH 3A", 130.0, 245.0, {"1": "VBAT_SW", "2": "SW_BOOST"})
    place(D, "D4", "SS34", 148.0, 245.0, {"1": "+5V", "2": "SW_BOOST"}, rot=270)
    place(C, "C6", "22uF 10V", 170.0, 245.0, {"1": "+5V", "2": "GND"})
    place(R, "R15", "100k", 190.0, 245.0, {"1": "+5V", "2": "FB_5V"})
    place(R, "R16", "13k", 204.0, 245.0, {"1": "FB_5V", "2": "GND"})
    place(R, "R13", "100k", 121.0, 266.0, {"1": "VBAT_SW", "2": "VBAT_ADC"})
    place(R, "R14", "100k", 139.0, 266.0, {"1": "VBAT_ADC", "2": "GND"})
    place(C, "C2", "100nF", 157.0, 266.0, {"1": "VBAT_ADC", "2": "GND"})
    text("Carga por el USB-C del TP4056 (IN+/IN- son su conector).", 13, 252)
    text("D4 es el diodo del elevador y bloquea el retorno del USB del DevKit.", 13, 255)
    text("R13/R14: 4.2 V de bateria -> 2.1 V en GPIO10 (ADC1).", 13, 258)
    text("Consumo estimado ~0.9 A de bateria con tiras al 50%:", 13, 263)
    text("unas 6.8 h nominales. Limitar tiras a 300 mA (MT3608).", 13, 266)
    text("MT3608: Vout = 0.6 V x (1 + R15/R16) = 5.2 V en el riel, con FB despues de D4.", 13, 271)
    text("EN a VIN. L1 con corriente de saturacion de 3 A o mas.", 13, 274)
    text("OPCION B: diseno discreto con TP4056, interruptor y MT3608 (alternativa a la opcion A).", 13, 280)
else:
    frame(10, 205, 215, 285)
    text("ALIMENTACION (OPCION A): MODULO LUORNG V8 PARA 2 x 18650, SALIDA DE 5 V", 13, 209, 2, True)
    place(BAT, "BT1", "18650", 33.02, 223.52, {"1": "VBAT_POS", "2": "GND"}, rot=270, ref_at=(0, -3.81, 1), val_at=(0, 3.81, 1))
    place(BAT, "BT2", "18650", 33.02, 236.22, {"1": "VBAT_POS", "2": "GND"}, rot=270, ref_at=(0, -3.81, 1), val_at=(0, 3.81, 1))
    place(MOD, "M1", "LUORNG V8 18650 x2", 100.0, 231.14,
          {"1": "VBAT_POS", "2": "GND", "3": "+5V", "4": "GND", "5": None},
          ref_at=(0, -9.0, 1), val_at=(0, 11.5, 1))
    place(R, "R13", "100k", 150.0, 240.0, {"1": "VBAT_POS", "2": "VBAT_ADC"})
    place(R, "R14", "100k", 168.0, 240.0, {"1": "VBAT_ADC", "2": "GND"})
    place(C, "C2", "100nF", 186.0, 240.0, {"1": "VBAT_ADC", "2": "GND"})
    text("M1 trae portapilas, carga USB-C o micro USB, boton ON/OFF y protecciones.", 13, 252)
    text("5V OUT (2.2 A nominales, 3 A de emergencia) al riel +5V y al pin 5V del DevKit. 3V OUT sin usar.", 13, 255)
    text("BAT+ y BAT-: contactos del portapilas, de ahi sale la medicion. BAT- y GND son comunes en el modulo (por confirmar).", 13, 258)
    text("R13/R14: 4.2 V de bateria -> 2.1 V en GPIO10 (ADC1).", 13, 262)
    text("Dejar el interruptor de modo del modulo en encendido continuo: en modo automatico se apaga con poca carga.", 13, 266)
    text("Consumo estimado ~0.9 A de bateria con las tiras en un color al 50%: unas 6.8 h nominales con 2 x 3000 mAh.", 13, 270)
    text("Pendiente: confirmar si el DevKit tiene diodo entre su USB y el pin 5V. Si no, no conectar USB con M1 encendido.", 13, 274)

# ---------------------------------------------------------------- notas


# ---------------------------------------------------------------- salida
POWER_NOTE = ("Alimentacion opcion A: modulo LUORNG V8 2x18650" if VARIANT == "A" else "Alimentacion opcion B: TP4056 + MT3608 discreto")
used = {b[2] for b in BOM}
lib_txt = "\n".join(v[0] for k, v in LIB.items() if k in used)
out = f"""(kicad_sch (version 20230121) (generator eeschema)
  (uuid {ROOT_UUID})
  (paper "A3")
  (title_block
    (title "Herramienta multiproposito para airsoft")
    (date "2026-11-08")
    (rev "v0.8-{VARIANT}")
    (comment 1 "Esquematico v1: ESP32-S3-DevKitC-1 + TFT 3.5in paralela de 16 bits")
    (comment 2 "Modos: bandera, zona, rey de la colina, bomba, extraccion")
    (comment 4 "{POWER_NOTE}")
    (comment 3 "Conexiones por etiqueta de red: etiquetas iguales = mismo nodo")
  )
  (lib_symbols
{lib_txt}
  )
{chr(10).join(ITEMS)}
  (sheet_instances (path "/" (page "1")))
)
"""
open(sys.argv[1], "w").write(out)

# BOM simple
import csv
with open(sys.argv[2], "w", newline="") as f:
    w = csv.writer(f)
    w.writerow(["Referencia", "Valor", "Simbolo"])
    for ref, val, lid, _ in sorted(BOM, key=lambda b: (re.sub(r"\d", "", b[0]), int(re.sub(r"\D", "", b[0])))):
        w.writerow([ref, val, lid])
print("ok", len(ITEMS), "elementos")
