rodgutzal/Airsoft-MultipurposeGameModeTool/(commit log)

2026-11-02 Agregar esquemático v0.1 con ESP32-S3 y pantalla TFT paralela
    Esquemático KiCad 7 generado por script, PDF, asignación de pines y
    lista de materiales con precios aproximados en MXN.
    Claude-Session: https://claude.ai/code/session_01Pcq7Hi5fgnZDbPpbNpZyXT
    [airsoft_tool.kicad_sch]
2026-11-02 Cambiar buzzer por amplificador I2S MAX98357A con bocina de 4 ohm
    El buzzer pasivo daría unos 40 dB a 15 m. El MAX98357A con bocina de
    3 a 5 W estima unos 70 dB a esa distancia. Usa GPIO40, GPIO45 y GPIO0.
    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
    [airsoft_tool.kicad_sch]
2026-11-02 Agregar lista de materiales en Excel
    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
    [lista_materiales_v0.2.xlsx]
2026-11-02 Reemplazar módulo elevador por MT3608 con componentes mínimos
    El módulo se sustituye por el circuito integrado MT3608 con su circuito
    típico: C5, L1, D4, C6 y divisor R15/R16 para 5.2 V. La realimentación
    se toma después del diodo.
    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
    [airsoft_tool.kicad_sch, lista_materiales_v0.2.xlsx, lista_materiales_v0.3.xlsx]
2026-11-02 Agregar opción A con módulo LUORNG V8 y conservar el diseño discreto como opción B
    La alimentación principal pasa a un módulo para 2 celdas 18650 con salida
    de 5 V. El diseño con TP4056 y MT3608 queda en opcion_b. El BOM en Excel
    trae ambas opciones.
    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
    [airsoft_tool.kicad_sch, airsoft_tool_opcion_B.kicad_sch, lista_materiales_v0.3.xlsx, lista_materiales_v0.4.xlsx]
2026-11-02 Mover el hardware a la carpeta Hw, crear Sw y actualizar el README
    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
    [airsoft_tool.kicad_sch, airsoft_tool_opcion_B.kicad_sch, lista_materiales_v0.4.xlsx]
2026-11-02 Agregar manuales de hardware del ESP32-S3 (TRM, datasheets y guia de diseno)
2026-11-03 Agregar proyecto base ESP-IDF para ESP32-S3 N16R8
2026-11-03 Quitar extern de InitRam y agregar Warnings.md y MemoryUsage.md
2026-11-03 Aplicar formato Allman, headers de archivo y funcion y nombres descriptivos
2026-11-03 Agregar GpioDriver con validacion de pin y entradas sin pull interno
2026-11-03 Agregar pull-ups externos de 10k en las columnas del teclado (R17 a R20)
2026-11-03 Hw v0.5: pull-ups externos en las columnas del teclado
    Agrega R17 a R20 (10k a 3V3) en KEY_C1 a KEY_C4 en las opciones A y B.
    Con R2, R3 y R4 todas las entradas digitales quedan con pull-up por
    hardware, como asume ConfigGpioAsInput. Regenera PDFs, actualiza la
    lista de materiales (v0.5) y los README.
    Claude-Session: https://claude.ai/code/session_01Pcq7HjMA95D38ydKB8bYUJ
    [airsoft_tool.kicad_sch, airsoft_tool_opcion_B.kicad_sch, lista_materiales_v0.4.xlsx, lista_materiales_v0.5.xlsx]
2026-11-03 Agregar TimerInitialization, timer periodico de 5 ms, constantes C_, uniones de banderas y reglas de formato
2026-11-03 Actualizar README de Sw con arquitectura, diagramas UML y relacion de archivos
2026-11-04 Hw v0.6: cambiar LEDs rojo/azul por dos tiras WS2812B
    Dos tiras RGB direccionables WS2812B de 5 V (DS2, DS3) en GPIO3 y GPIO46,
    con subida de nivel 74AHCT125 (U5), 330 ohm en serie en cada dato,
    C8 de 1000 uF en la entrada de las tiras y C7 de 100 nF en U5.
    Se quitan D1, D2, Q1, Q2, R7 y R10. R6 y R9 quedan como pull-downs
    de los datos. README con calculo de consumo y autonomia, BOM v0.6 y
    renombre de los pines en el firmware.
    Claude-Session: https://claude.ai/code/session_01Pcq7HijQKbV7ZyHeaj2nUW
    [airsoft_tool.kicad_sch, airsoft_tool_opcion_B.kicad_sch, lista_materiales_v0.5.xlsx, lista_materiales_v0.6.xlsx]
2026-11-04 Agregar documento de arquitectura y mover el reloj a ClockDriver
2026-11-04 Incluir Ram.h en lugar de GlobalDefine.h y agregar el interruptor C_RAM_EXPOSE_GLOBALS
2026-11-04 Agregar .gitignore en la raiz y .clangd al de Sw
2026-11-04 Refactor de encapsulamiento: TimerDriver con estado privado, arranque unico y Ram reducida al modelo
2026-11-04 Agregar FlashDriver (NVS), tabla de particiones propia y ISR del timer segura en IRAM
    [partitions.csv]
2026-11-07 Agregar LED de estado verde en GPIO43 (esquemático v0.7)
    D5 (LED verde 5 mm) y R21 de 330 ohm de GPIO43 a GND, activo en alto,
    unos 3.6 mA. Regenerados los esquemáticos y PDFs de las opciones A y B,
    lista de materiales v0.7 y define C_PIN_LED_ESTADO en el firmware.
    GPIO43 es U0TXD: el README explica el parpadeo en el arranque y que la
    consola debe salir de UART0.
    Claude-Session: https://claude.ai/code/session_01Pcq7Hm5vf8CFzbprGWm6XQ
    [airsoft_tool.kicad_sch, airsoft_tool_opcion_B.kicad_sch, lista_materiales_v0.6.xlsx, lista_materiales_v0.7.xlsx]
2026-11-08 Agregar HeartbeatDriver (LED en GPIO43, ciclo de 1 s), SetGpioLevel y consola por USB-Serial-JTAG
2026-11-08 Esquemático v0.8: pinout de la pantalla 2x17 de 16 bits
    La pantalla de Roy es el módulo 3.5" ILI9486 con conector 2x17 (34 pines),
    bus 8080 de solo 16 bits y touch XPT2046 por SPI. El esquemático suponía
    un shield UNO de 8 bits con touch multiplexado en el bus.
    - DS1 con los 34 pines de la serigrafía, pin 1 = CS.
    - LCD_D8 a LCD_D15 en GPIO8, 9, 11, 12, 13, 14, 21 y 47.
    - Touch SPI: CLK GPIO38, MOSI GPIO46, MISO GPIO48, T_CS GPIO41.
    - CS a GND, RD a 3V3 con R1, RST al EN de la tarjeta.
    - VDD a 3V3; pin 5V (BL_VDD) sin conectar; SDCS y F_CS a 3V3.
    - Expansor MCP23017 (U6) por I2C en GPIO39/42 para teclado, switches,
    botón, PEN y BL; R7, R10, R11 y C9 nuevos.
    - Las dos tiras WS2812B qu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
    [airsoft_tool.kicad_sch, airsoft_tool_opcion_B.kicad_sch, lista_materiales_v0.7.xlsx, lista_materiales_v0.8.xlsx]
2026-11-08 Esquemático v0.9 opción C: todo discreto para PCB propia
    Quita el ESP32-S3-DevKitC-1, el módulo LUORNG V8 y la tarjeta MAX98357A.
    Módulo ESP32-S3-WROOM-1-N16R8 con EN RC, BOOT, RESET y pines de arranque;
    USB-C al USB nativo con ESD y header UART0; TP4056, DW01A + 2x FS8205A,
    reparto de carga USB/batería, TPS61022 a 5.1 V y AP7361C a 3.3 V;
    MAX98357A suelto con SD_MODE por U6 GPB5.
    Claude-Session: https://claude.ai/code/session_01Pcq7Hinuf9NpPUS19rqTdu
    [airsoft_tool_opcion_C.kicad_sch, lista_materiales_v0.9_opcionC.xlsx]
2026-11-12 PCB opción C v0.2: ruteo preliminar con Freerouting y vistas por capa
    Trae la propuesta v0.1 (PR #19, que quedó en la rama del PR #18 y no
    llegó a develop) y agrega el ruteo preliminar:
    - rutear.py exporta a Freerouting con L2 como plano de GND y la
    potencia solo en L1/L4, carga el .ses, ensancha las pistas de potencia
    hasta donde dejan las separaciones, agrega rellenos de GND en L1 y L4
    y vías de costura.
    - vistas_pistas.py genera la vista combinada y una por capa.
    - pcb_propuesta_v0.2.md: sección de ruteo preliminar con las 5
    conexiones sin terminar y lo que hay que rehacer a mano.
    DRC: sin violaciones de separación ni de cobre al borde.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
    [airsoft_tool_opcion_C.kicad_pcb, airsoft_tool_opcion_C.kicad_sch]
2026-11-12 PCB opcion C v0.3: placa de 2 capas y nuevo ruteo preliminar
    Pasa la PCB a 2 capas (F.Cu y B.Cu, 1 oz), quita la regla de capas internas,
    rutea de nuevo con Freerouting, agrega rellenos de GND en las dos caras y
    revisa las vias de costura contra el cobre de otras redes. Vistas por cara y
    documento pcb_propuesta_v0.3.md.
    Claude-Session: https://claude.ai/code/session_01Pcq7Hi6ubpxSHQ2b7dFrLA
    [airsoft_tool_opcion_C.kicad_pcb]
2026-11-12 Documentar el proyecto: guia de desarrollo, referencia de API, mapa de pines y comentarios de variables
2026-11-13 Arquitectura: soporte de los controladores ILI9486 y ST7796U en DisplayDriver
2026-11-13 DisplayDriver y paneles ILI9486 / ST7796U sobre bus i80 de 16 bits
2026-11-13 DisplayDriver: mutex, limpieza al fallar el init, validacion de bitmap y esperas del ST7796 recortadas
2026-11-13 DisplayDriver: constantes C_LCD_*, estado tras fallo de init y notas del ISR y de INVON
2026-11-13 DisplayDriver: intercambiar bytes de color solo con bus de 8 bits
2026-11-13 DisplayDriver: no liberar recursos con un DMA expirado aun activo
